ManiTiTz/raunkerfi/rover-build/SWCAD/SWCAD/Import/thingiverse-mount-SharpIR-GP2Y0A21YK0F/images/e8e99f86aa6a258e2d7d2b59b1ce71c8.png

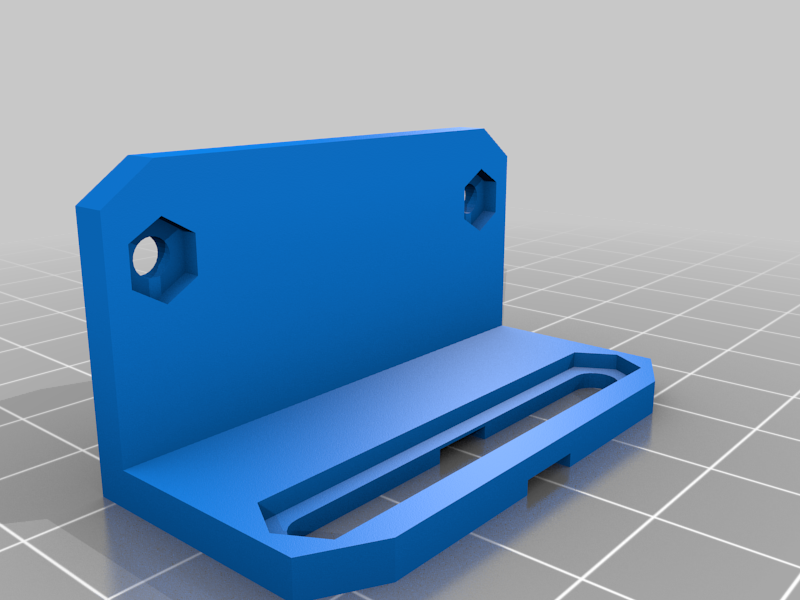
rover-build/SWCAD/SWCAD/Import/thingiverse-mount-SharpIR-GP2Y0A21YK0F/images/e8e99f86aa6a258e2d7d2b59b1ce71c8.png
