ManiTiTz/raunkerfi/rover-build/SWCAD/SWCAD/Import/LM2596 DC-DC convertor HW-411 - 5719964/images/8448f583-9351-4d56-b564-8d736e37746e.png

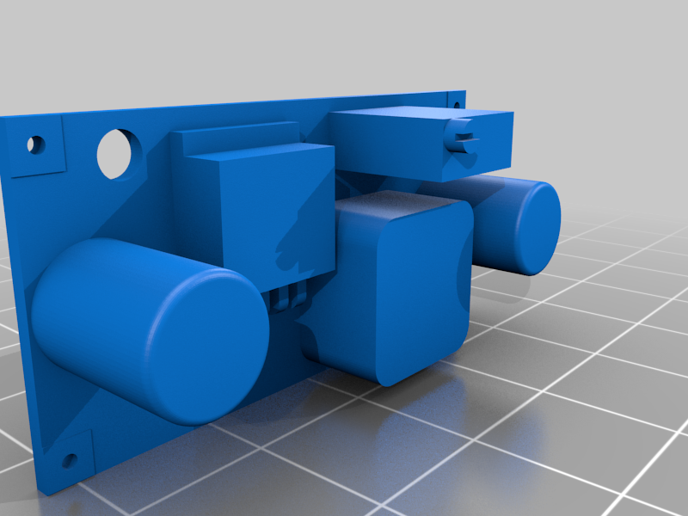
rover-build/SWCAD/SWCAD/Import/LM2596 DC-DC convertor HW-411 - 5719964/images/8448f583-9351-4d56-b564-8d736e37746e.png
