ManiTiTz/raunkerfi/rover-build/SWCAD/SWCAD/README.txt

2025
Caster https://www.dfrobot.com/product-225.html

Powerbank options
https://ikea.is/is/products/heimaskrifstofan/fjoltengi-hledslutaeki-og-rafhlodur/fjoltengi-og-hledslutaeki/varmfront-hledslubanki-art-10555645
https://www.alibaba.com/product-detail/2022-Promotion-Gift-5000Mah-Pocket-Power_1600108552990.html

Protoboards instead of breadboards
https://www.aliexpress.com/item/1005007129593182.html
