ManiTiTz/raunkerfi/rover-build/SWCAD/SWCAD/ASM-robot-chassis-2025.pdf

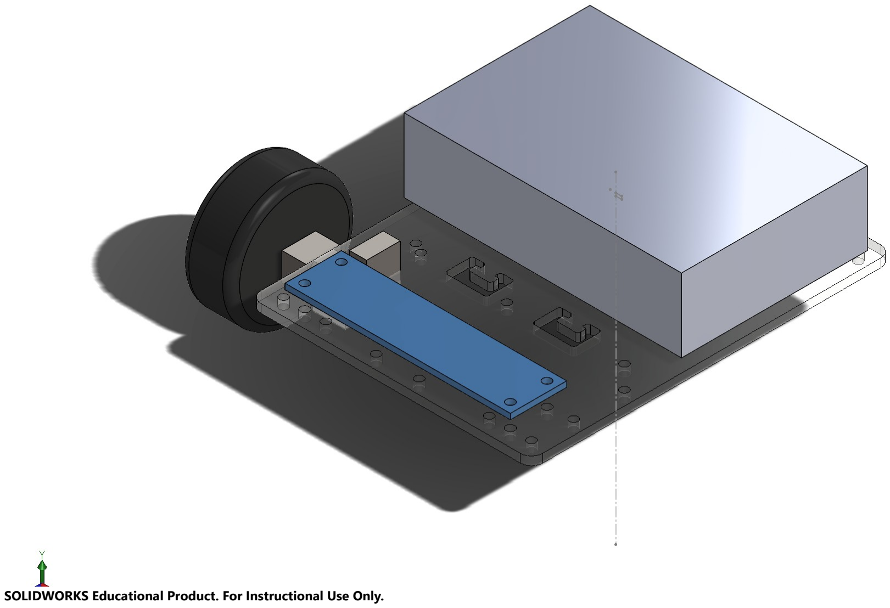
[picture p3: page 1]

SOLIDWORKS Educational Product. For Instructional Use Only.
