ManiTiTz/raunkerfi/rover-build/SWCAD/SWCAD/ASM-robot-chassis-2026-sensorboard.pdf

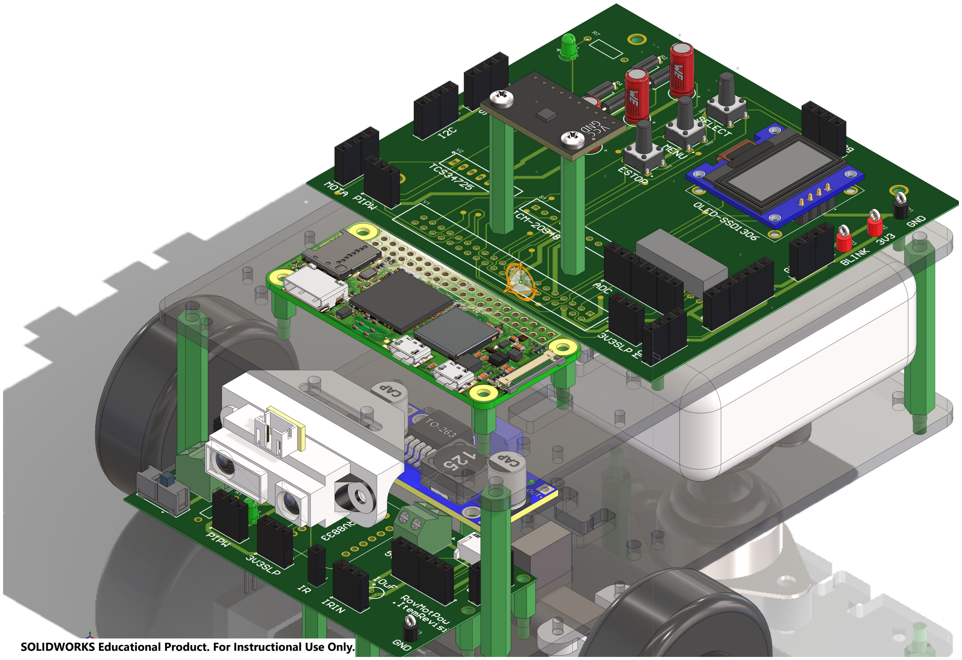
[picture p4: page 1]

SOLIDWORKS Educational Product. For Instructional Use Only.
