ManiTiTz/raunkerfi/rover-build/SWCAD/SWCAD/ASM-robot-chassis-2026.pdf

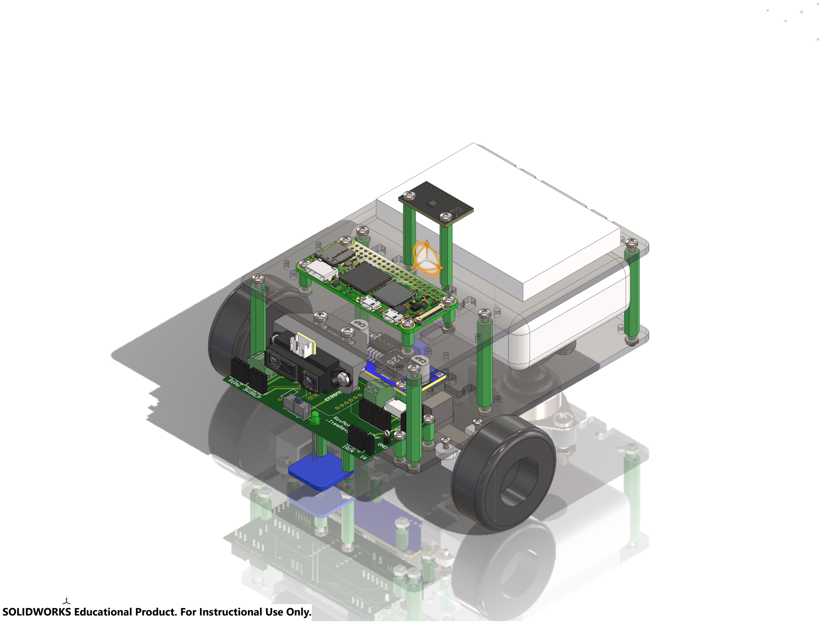
[picture p5: page 1]

SOLIDWORKS Educational Product. For Instructional Use Only.
