ManiTiTz/raunkerfi/books/Book Aug 27, 2026.pdf

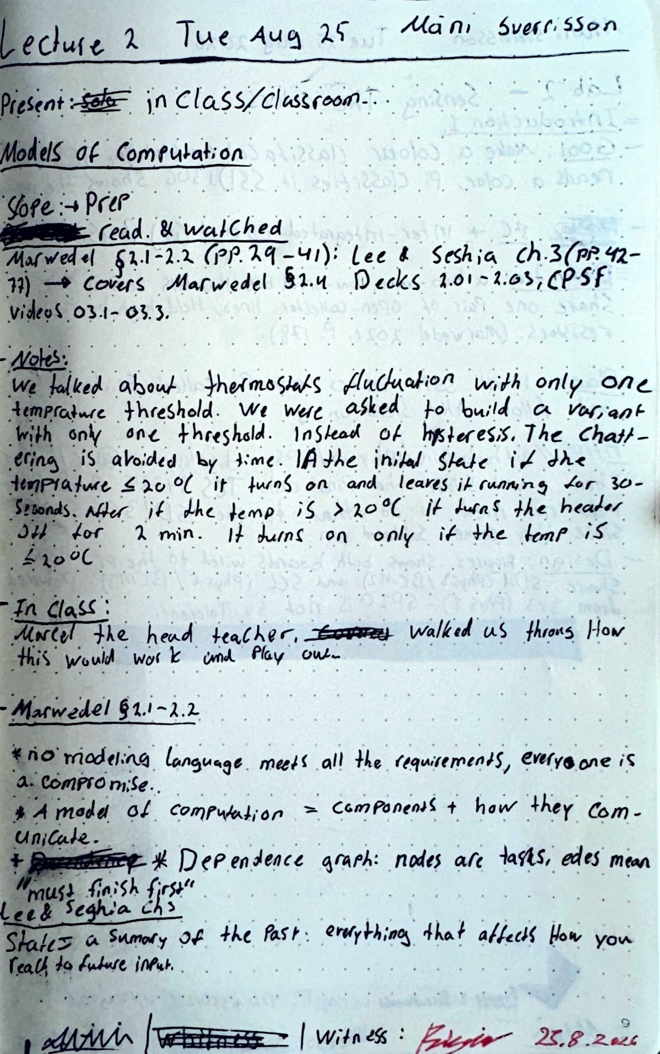
[picture p6: page 1]

### -- ~s~,,~ • . 1:n ~ (a_$S/¢/~~(_t>6~-> -: | • ' • t I I ._•. •

. . . . I
·t1! at· (om,~i~to/\ • • • • . .

~~~~r·....... ·.:: ~ .
. ~f • •• itfA'J..·,;.·we..{Ched •
~~~. ~I . §~.I~ l ._l. (i~f. A 'f. - ~ /) ;· :t ~ l :1. : s:es~; ~ • °c~-3{Pf: tfZ-.1)) ~ ~~U".!. --"'~w~J~l _§;.c.t .0.~,~~- ~-o~ -i:~1>,CP·S:f .
. ~•••,\. O}.f-:- ~~- } | '· · · ".

:~~ktJ :~~o~: }h~~s~s: /J~{kQJ;o~ :w!ih ~n;y : o~e_

.-l•PfQ.JM.le thrtSho/cJ. Wt Wet{. a,$keJ. J-.o b1.tilJ Col Vt;,.,;·.:,nl-
. fi~ ~nv : O~l,-_ f_hrfS~G'~·. JnS~ :01-. ~!e<:t<;if, 7~e.: Cl:z~!- . ,,,~ . is. ~ l,o'.'<At_cl by !:tv1 t ·. I~ ~A~ i_h,'J../. 51-eJe i I J~<

.ffrJ'4fw_t, ~ ).c,_ 0 ( ~t . J~n~ ~I\. e21uA_ l_t"~tS_ ii-_ r~11,_'n~ ~or_ ~-~S .. _ ~ )/._ t~t.. l~IY\.P . ;5 .> ~o 0

( fl- _J..rn~ fit~ J,~aJ,.,,_ . ~-,P.~ • ~or_ . 1_ ~·in. II- Jurn! ~" . o_nly ii- fht!. .km!'. ,'f . ~\o 0 l • • • ••• t • O ♦ t t • 4 • • f •I' .. ••• ♦ • •

~~./J,~'J §1.i-i.i • • • • • • • • |

\~0 ~ ~~t/.·~ta: ~119CA-.~e. ;teJ { '~,; l.~e. (f_'f~t~t,rt~JSI ~r'('lso,,e i~~ «,. Co"1,r c, n,Je.

:- ~ m~J.~ Ot. ~O~f¥fAJ10~ ;_ Cr.~Po/l~nJ~ t: 1-io,V :~~ey' ~ni-
UnJ4«-k | t • ✓• • ~ D eP e11.Je~c t ~~,,~= . n()(/,J ~r, +~~s,. ed,s" mtAA

~fl .f.11.:Sh- f;t1J:1
' | •
1,I >e •~ Cl\)
,~ CA ~~-Y ~I +"-t. f~ri,: qtffytt·,,~· ,lk,,.f ~lh.tJ{ ifo~ yo~
l',-(4 ~ ~t j"'""· | •
- • .. • • • • 11 • • • • • ' • • • '

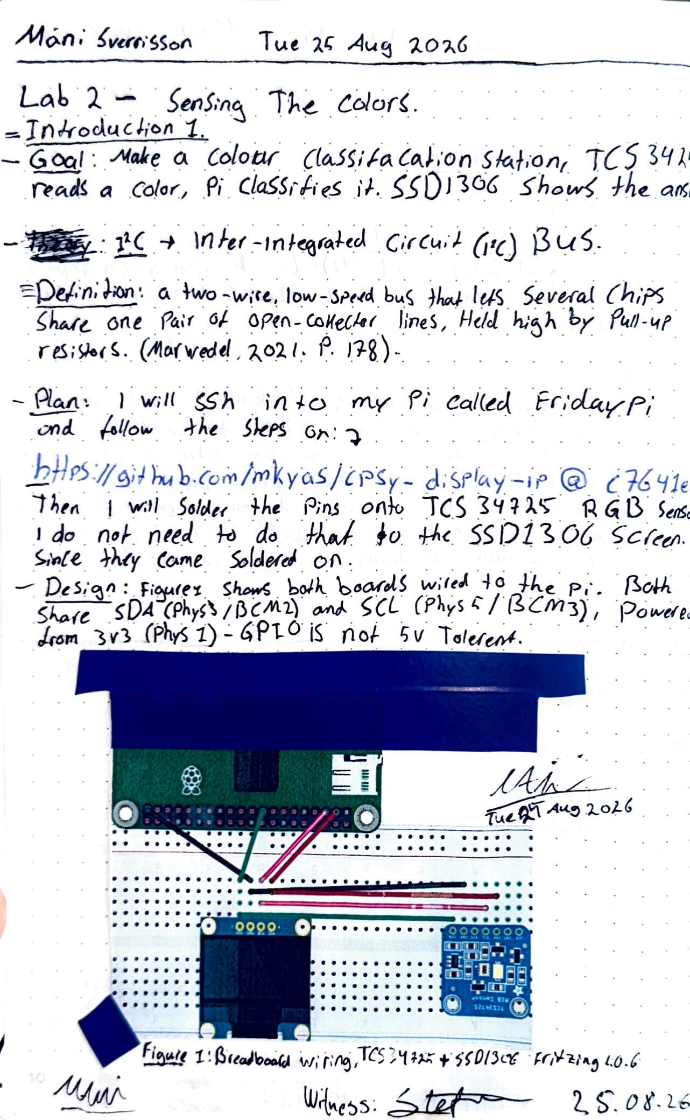
[picture p7: page 2]

### L~b: 1: ~ : $M$tn:~ : i~i : c~~r(. : : .• _' _' .•

~Jnkoclu.cJ,011 1.
- ·Goar: -~at~ ~ .c~1o~: (l~5~il~ (,~.),·o_n ~~f,·o;,f. T.(5 ~4 ~I r,c-ttl~ a .Cc,lor, .Pi. C(a5,St/.i'e~ ,ii .. ~SOJ~~(;. Sho_w{ +h~ a~,

--- ~ J1( ➔: lhfer:-,nf~r~l-t:r.A :c,:rc~.) ()'Cj }3~5: .. ~

=Pl/,:n:J.iOll·. •o.'two~w.:,t; lo,w-·~,,~,(~·b~~ jlu,j. t~s· ~vu-ai {h;fS
~w~ _Otl_t : P~i,: 6~ ~p~"-: eo~ihr: (ine_S ~ :He/cl : ht•~}< by f~tl-~f
re.s;~<_~ .. (~ca(w-~tf,i_o'.)./_. ~- 1_18,)k. . | . ....

### - Pl~·\ • I. ~;1( ~h • in .i.o ·m.v. f/ ea(c~~ :f~,·~v.F/ •

~: ~//~w: :-+~t: ~:k~ :0;:; : : : . . . . .

### _hHP~-t( ~'.J ~ ~-~o~l~~y:u5/ ~1-:)sy:- J;~fl~y-,:f ~: ( t6 '-f Je

1 ~trt I w:H 5olr.Au +he P;,u of\tv i C $ 1 '1 't A~ ~ ~ t1. Sen5<

### - ao: no/-: n1eJ: ~ -d~ }A,) :+o: +./,<=: SSl)t s:o? <;cred'-

>ty,_te_ +hty ~~~e. :5>(olerd. c>" · | • • - D~.s1·~,_, :_f,.~<.t1. s~. b~k.. b.oG\fJ~ ~;,~J. ➔~ -J.~~- p~·- • P.>oJA

S~{~ .~OA. (~hy~\ iBCM1.)_ -~- ~~L. (Ph~S ~ I_B>~~1)_ 1 ·eowelec
J.ro,,. sv1 (PhyS t).:. ~-pio IS ()of r;v Taluel)-I. | • • . | | | . | . | .

r

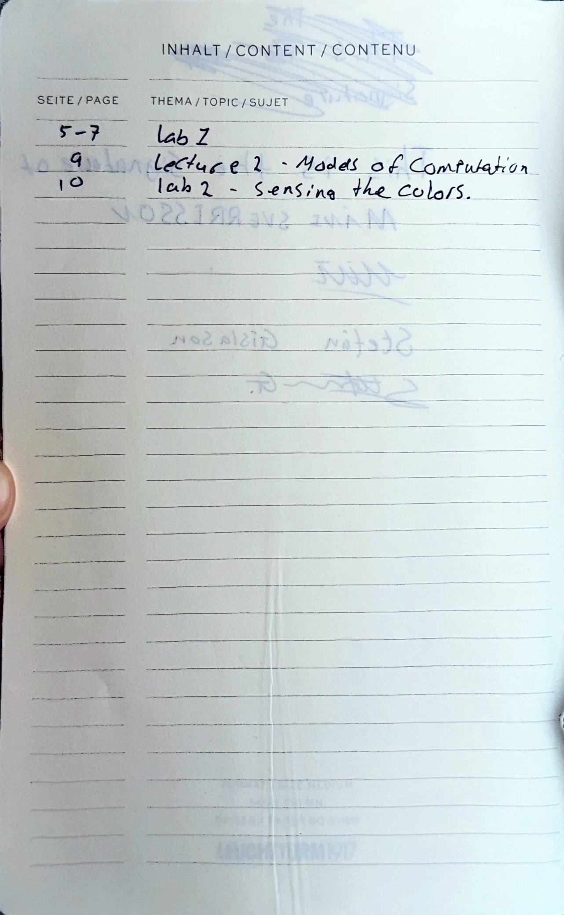
[picture p8: page 3]

SEITE / PAGE
r-1-
q
,o

IN HALT/ CONTENT/ CONTE NU

TH EMA /TOPIC/ SUJET

### iAb Z __

_ le.<_./4c_f_2_ :_ 1/a~~1 o l .LOIY'--fr,JcJr'o11.
I c.tl> l_::_ __ S .e ttS / "-~- Jlue_ Co tcrS.

---·- -----

,
- I
I
