ManiTiTz/raunkerfi/Lab1/0b20301a-474d-4d77-a737-266983e7a903.pdf

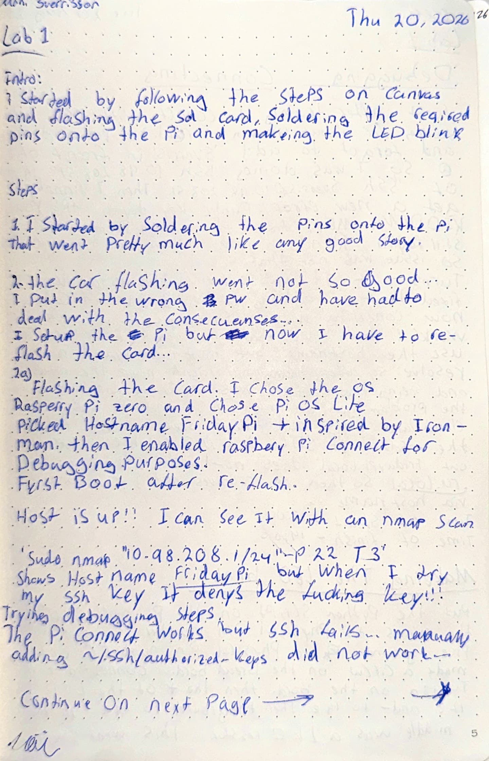
[picture p9: page 1]
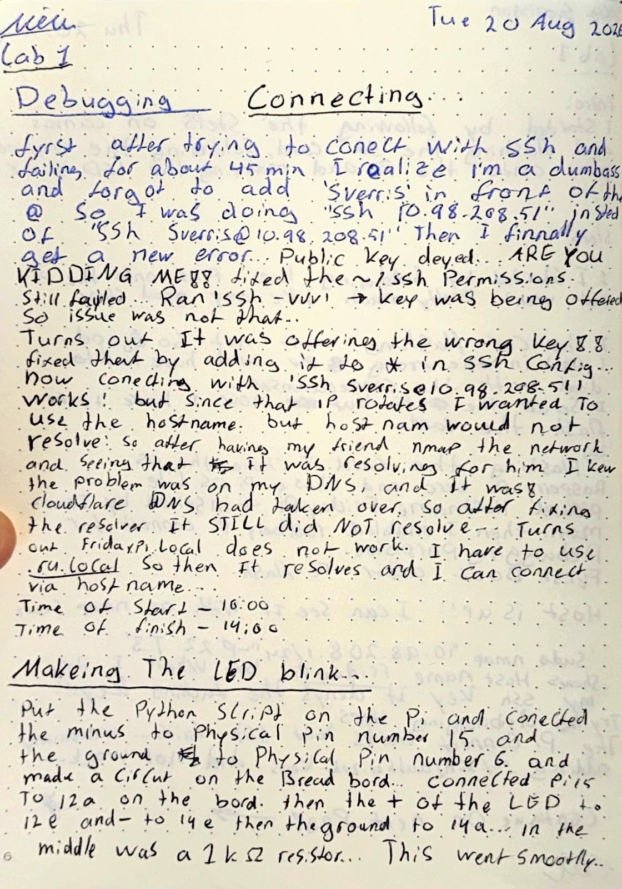
[picture p10: page 2]
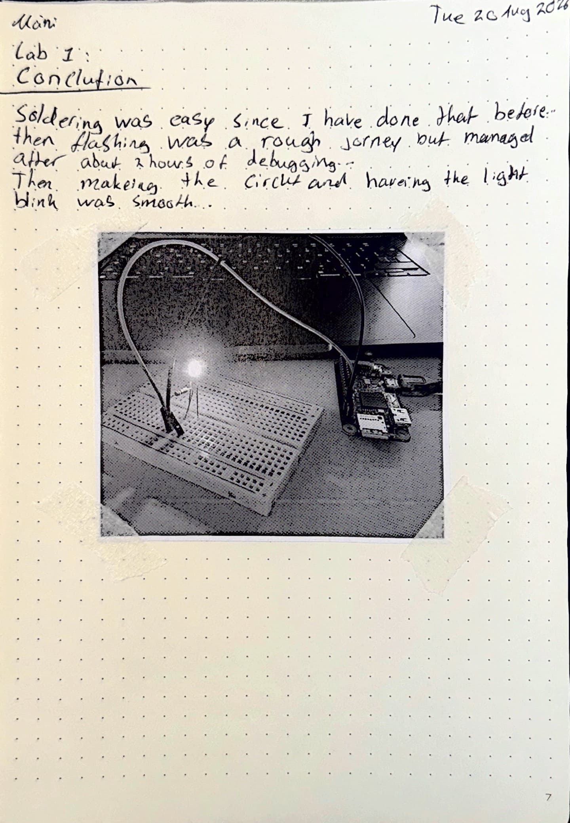
[picture p11: page 3]
