ManiTiTz/raunkerfi/4lab/2026-09-08-07.png

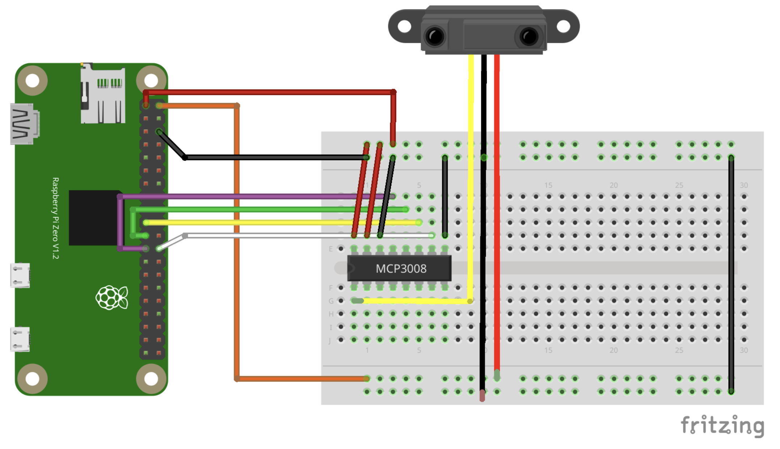
4lab/2026-09-08-07.png
