ManiTiTz/raunkerfi/4lab/2026-09-08_15-07.png

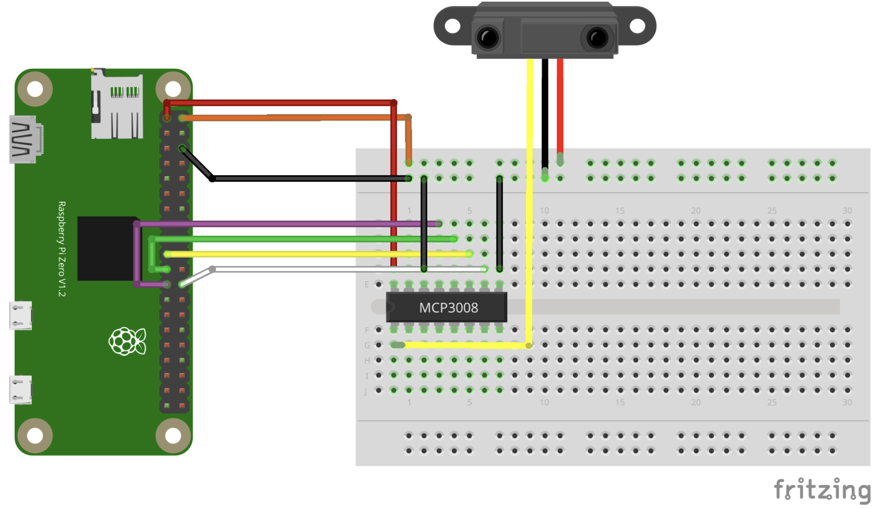
4lab/2026-09-08_15-07.png
