ManiTiTz/raunkerfi/rover-build/SWCAD/SWCAD/ASM-TireHub.SLDASM

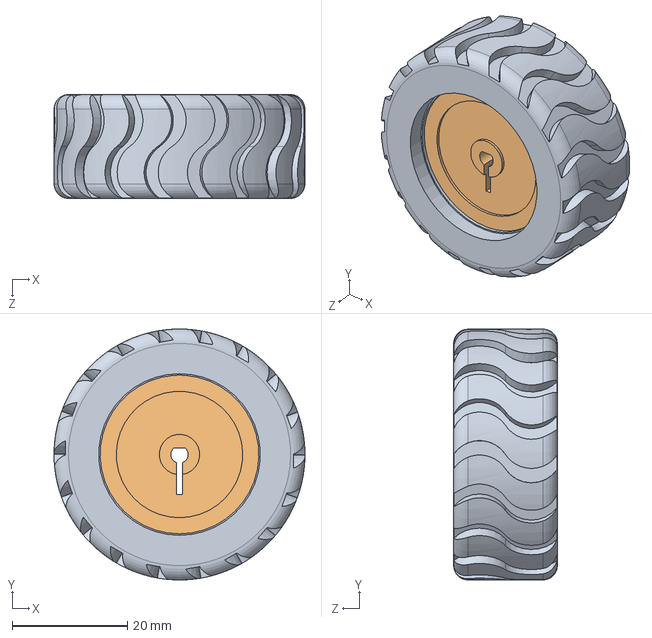
[picture p14: CAD file, 2026-10-19]
rover-build/SWCAD/SWCAD/ASM-TireHub.SLDASM
43.5 x 43.5 x 18.0 mm
hub
tire
