ManiTiTz/raunkerfi/rover-build/SWCAD/SWCAD/ASM-caster.SLDASM

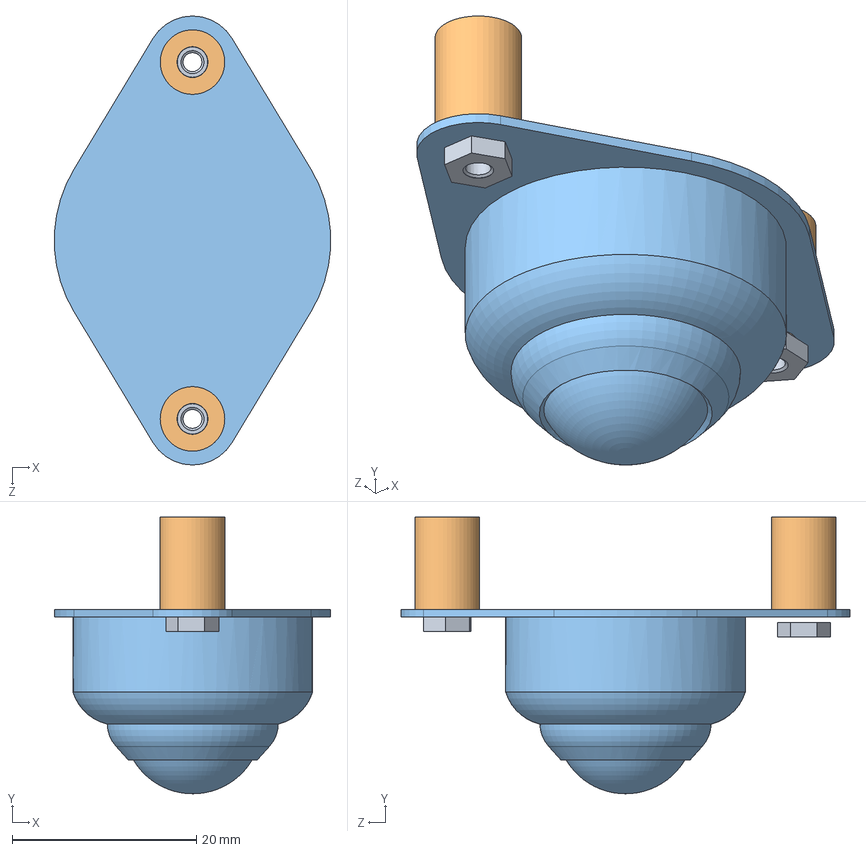
[picture p15: CAD file, 2026-10-19]
rover-build/SWCAD/SWCAD/ASM-caster.SLDASM
29.9 x 30.0 x 48.7 mm
caster-dfrobot225
spacer-caster x 2
nuts-metal x 2
