ManiTiTz/raunkerfi/rover-build/SWCAD/SWCAD/ASM-WheelMotor.SLDASM

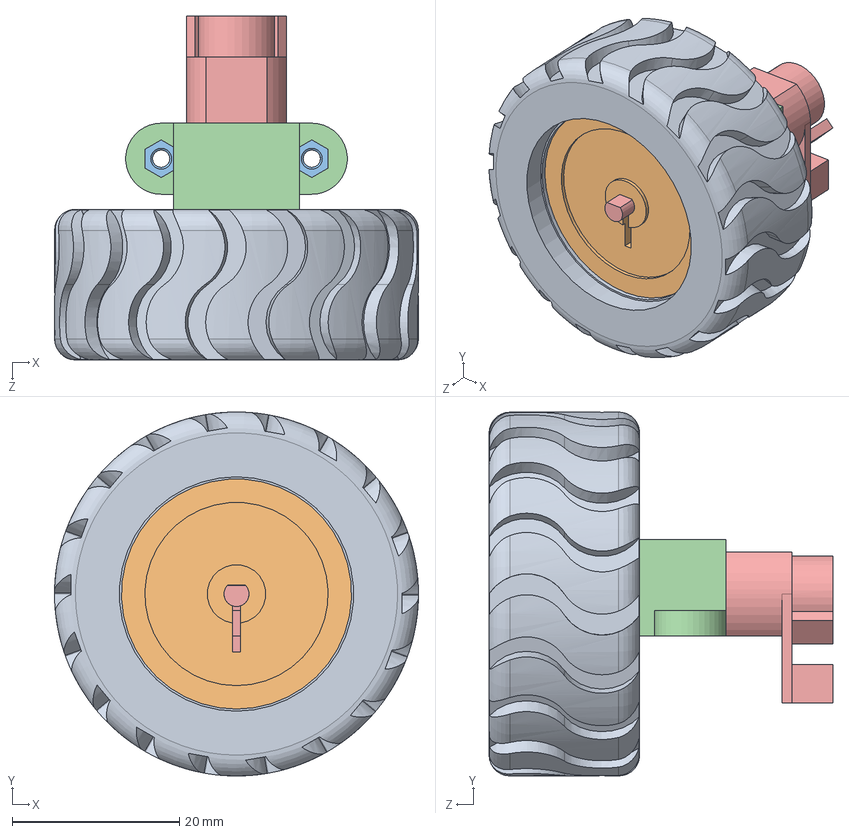
[picture p16: CAD file, 2026-10-19]
rover-build/SWCAD/SWCAD/ASM-WheelMotor.SLDASM
43.5 x 43.5 x 41.1 mm
motor
bracket-motor
nuts-metal x 2
hub
tire
