ManiTiTz/raunkerfi/rover-build/SWCAD/SWCAD/ASM-ColorSensor.SLDASM

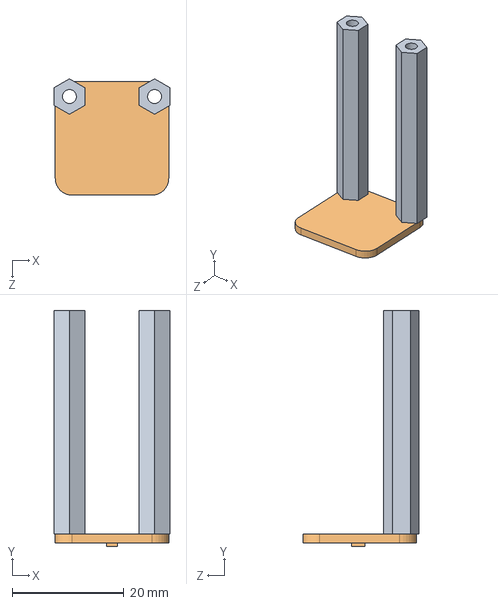
[picture p17: CAD file, 2026-10-19]
rover-build/SWCAD/SWCAD/ASM-ColorSensor.SLDASM
20.7 x 42.2 x 20.8 mm
sensor-color-tcs34725
standoff x 2
