ManiTiTz/raunkerfi/rover-build/SWCAD/SWCAD/ASM-DistanceSensor.SLDASM

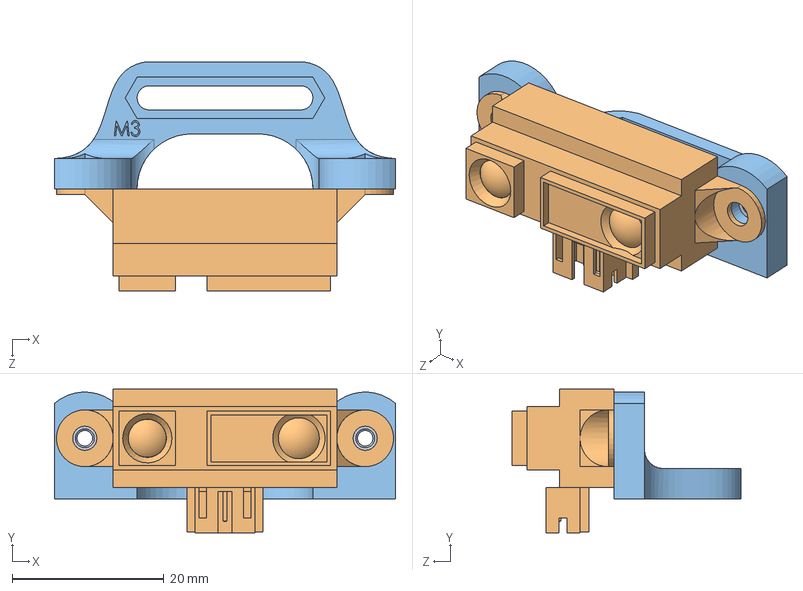
[picture p18: CAD file, 2026-10-19]
rover-build/SWCAD/SWCAD/ASM-DistanceSensor.SLDASM
45.0 x 19.0 x 30.3 mm
bracket-sharp
sensor-Sharp2Y0A21
nuts-metal x 2
