ManiTiTz/raunkerfi/rover-build/SWCAD/SWCAD/AliExpress-ICM20948-IMU-EDM/AliExpress-ICM20948-IMU_BOARD.SLDPRT

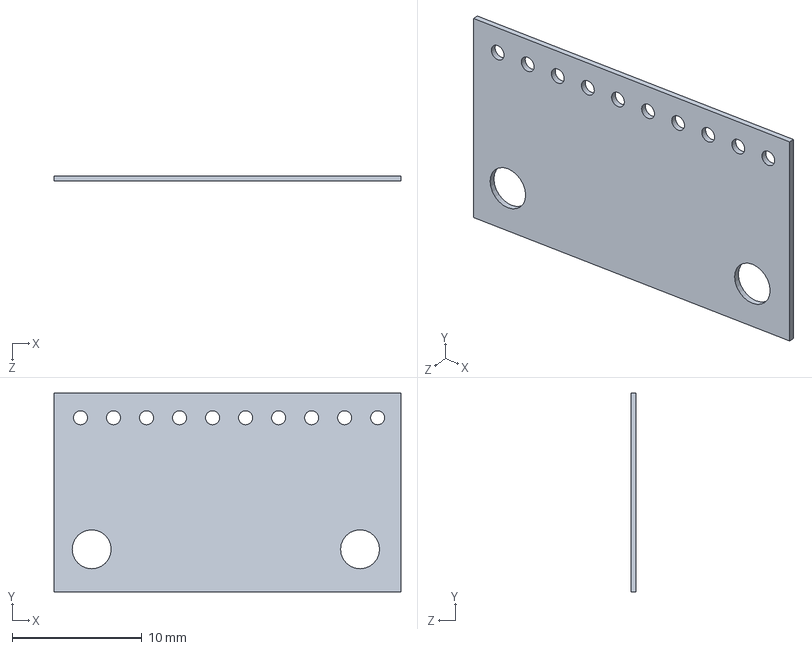
[picture p19: CAD file, 2026-10-19]
rover-build/SWCAD/SWCAD/AliExpress-ICM20948-IMU-EDM/AliExpress-ICM20948-IMU_BOARD.SLDPRT
26.7 x 15.3 x 0.411 mm
