ManiTiTz/raunkerfi/rover-build/SWCAD/SWCAD/Import/LM2596 DC-DC convertor HW-411 - 5719964/files/LM2596_DC-DC_convertor_HW-411.obj

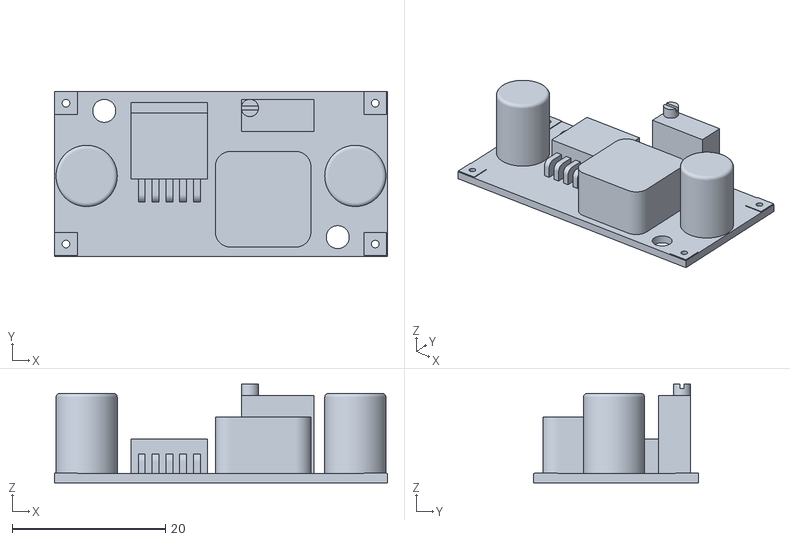
[picture p20: CAD file, 2026-10-19]
rover-build/SWCAD/SWCAD/Import/LM2596 DC-DC convertor HW-411 - 5719964/files/LM2596_DC-DC_convertor_HW-411.obj
43.5 x 21.5 x 12.9
