ManiTiTz/raunkerfi/rover-build/SWCAD/SWCAD/Import/marcel-caster-spacer.stl

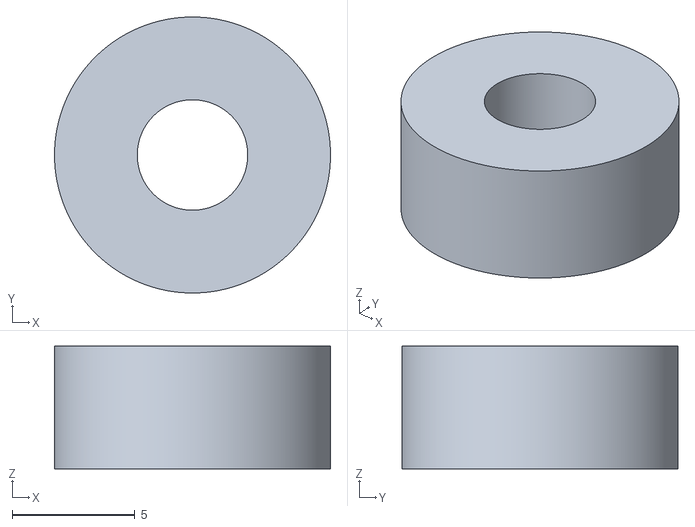
[picture p21: CAD file, 2026-10-19]
rover-build/SWCAD/SWCAD/Import/marcel-caster-spacer.stl
11.2 x 11.2 x 5.00
