ManiTiTz/raunkerfi/rover-build/SWCAD/SWCAD/Import/thingiverse-mount-SharpIR-GP2Y0A21YK0F/files/Support_Capteur_Sharp2.SLDPRT

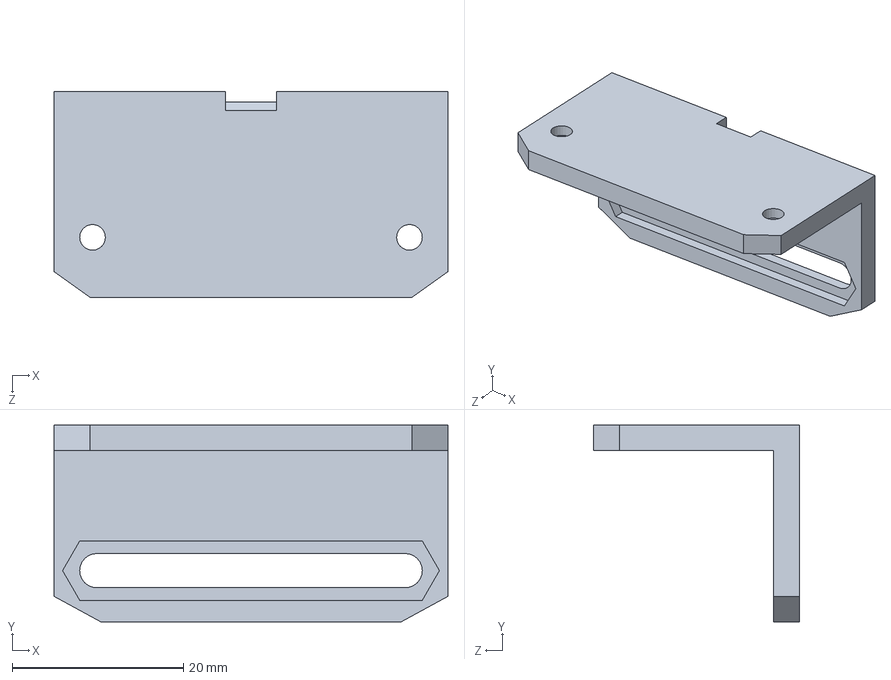
[picture p22: CAD file, 2026-10-19]
rover-build/SWCAD/SWCAD/Import/thingiverse-mount-SharpIR-GP2Y0A21YK0F/files/Support_Capteur_Sharp2.SLDPRT
46.0 x 23.0 x 24.0 mm
