ManiTiTz/raunkerfi/rover-build/SWCAD/SWCAD/RoverMotorPower-EDM/RoverMotorPower_BOARD.SLDPRT

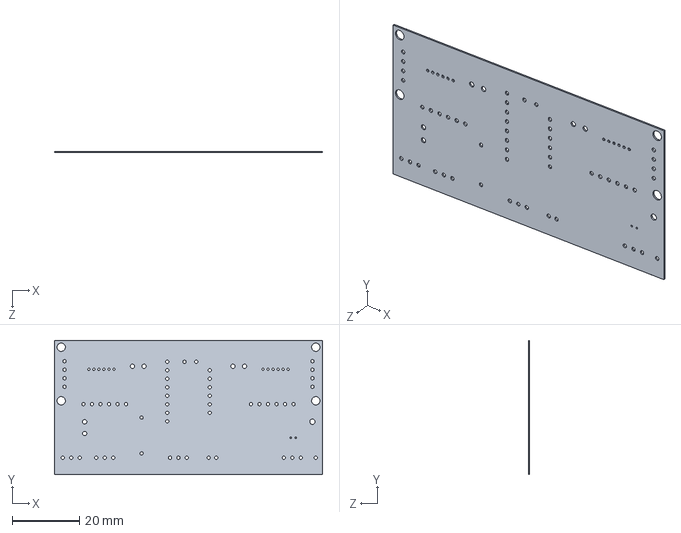
[picture p23: CAD file, 2026-10-19]
rover-build/SWCAD/SWCAD/RoverMotorPower-EDM/RoverMotorPower_BOARD.SLDPRT
80.0 x 40.0 x 0.411 mm
