ManiTiTz/raunkerfi/rover-build/SWCAD/SWCAD/RoverSensor-EDM/Assem2_BOARD.SLDPRT

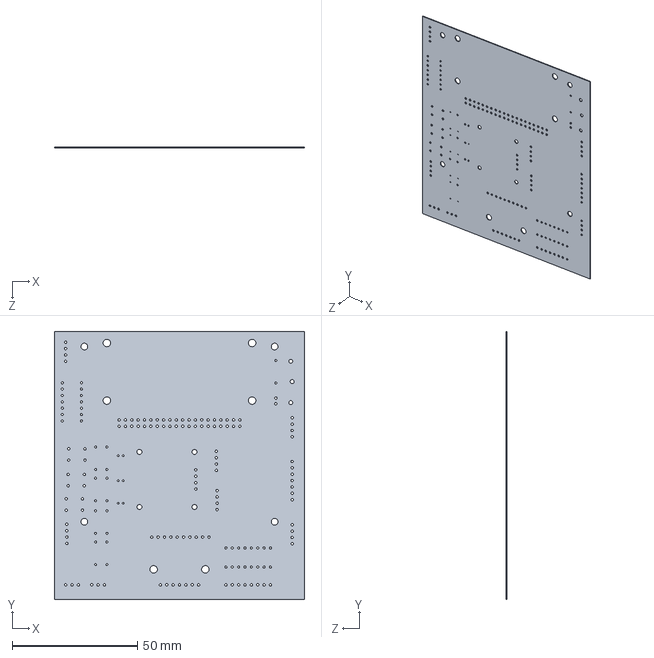
[picture p24: CAD file, 2026-10-19]
rover-build/SWCAD/SWCAD/RoverSensor-EDM/Assem2_BOARD.SLDPRT
100.0 x 107.0 x 0.411 mm
