ManiTiTz/raunkerfi/rover-build/SWCAD/SWCAD/tire.SLDPRT

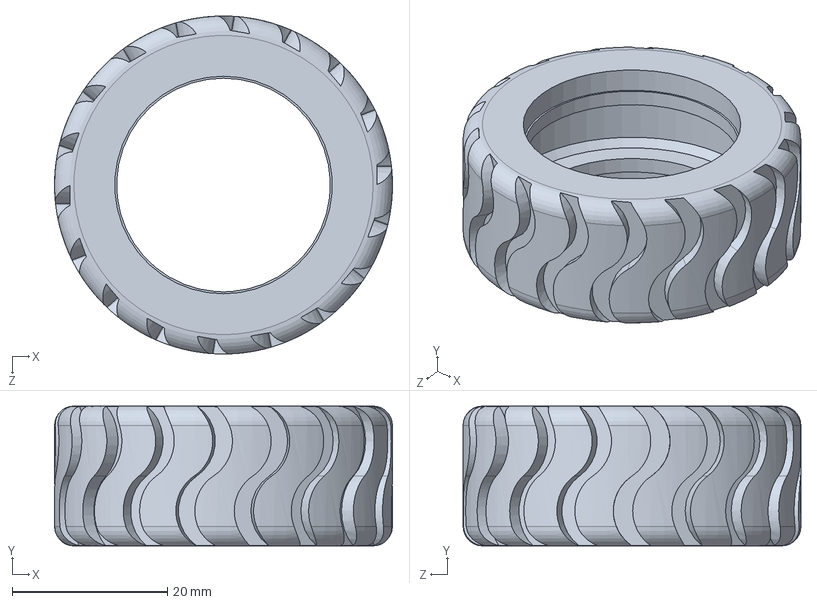
[picture p25: CAD file, 2026-10-19]
rover-build/SWCAD/SWCAD/tire.SLDPRT
43.5 x 18.0 x 43.5 mm
