ManiTiTz/raunkerfi/rover-build/SWCAD/SWCAD/motor.SLDPRT

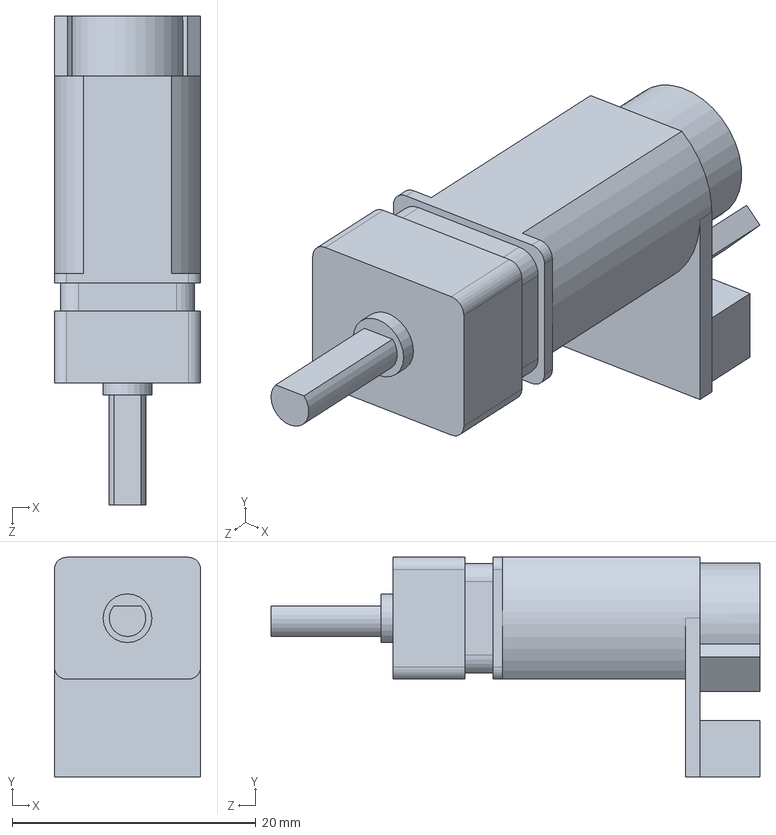
[picture p26: CAD file, 2026-10-19]
rover-build/SWCAD/SWCAD/motor.SLDPRT
12.0 x 18.0 x 40.1 mm
