ManiTiTz/raunkerfi/rover-build/SWCAD/SWCAD/baseplate-1layer.SLDPRT

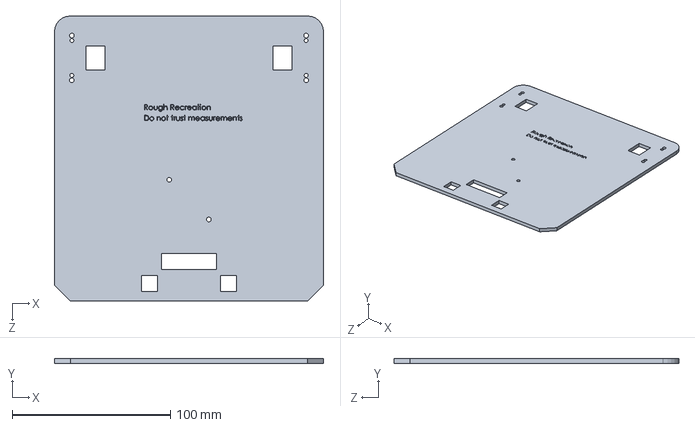
[picture p27: CAD file, 2026-10-19]
rover-build/SWCAD/SWCAD/baseplate-1layer.SLDPRT
170.0 x 3.00 x 180.0 mm
