ManiTiTz/raunkerfi/rover-build/SWCAD/SWCAD/bracket-sharp.SLDPRT

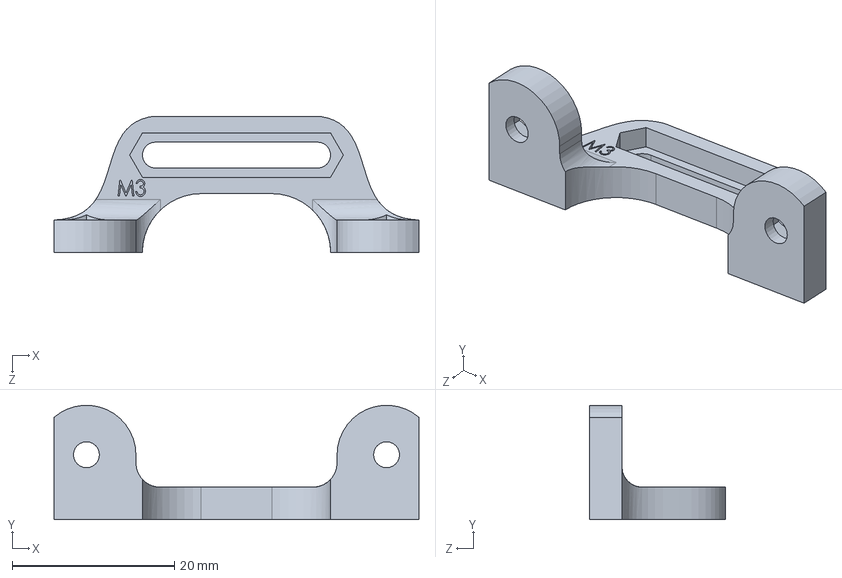
[picture p28: CAD file, 2026-10-19]
rover-build/SWCAD/SWCAD/bracket-sharp.SLDPRT
45.0 x 14.1 x 16.8 mm
