ManiTiTz/raunkerfi/rover-build/SWCAD/SWCAD/spacer-oldstandoff.SLDPRT

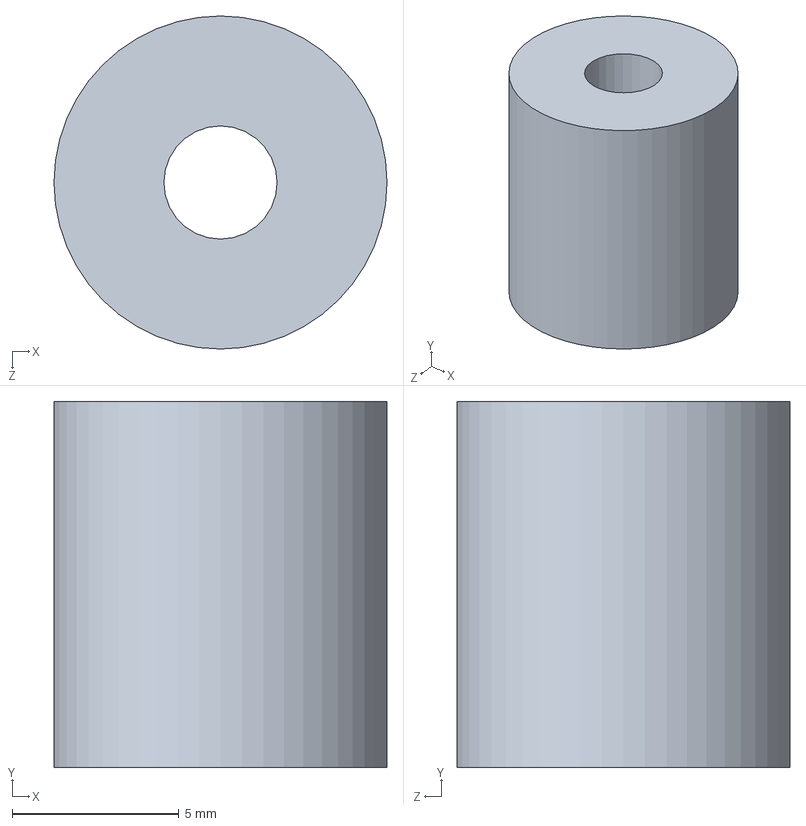
[picture p29: CAD file, 2026-10-19]
rover-build/SWCAD/SWCAD/spacer-oldstandoff.SLDPRT
10.0 x 11.0 x 10.0 mm
