ManiTiTz/raunkerfi/rover-build/SWCAD/SWCAD/spacer-caster.SLDPRT

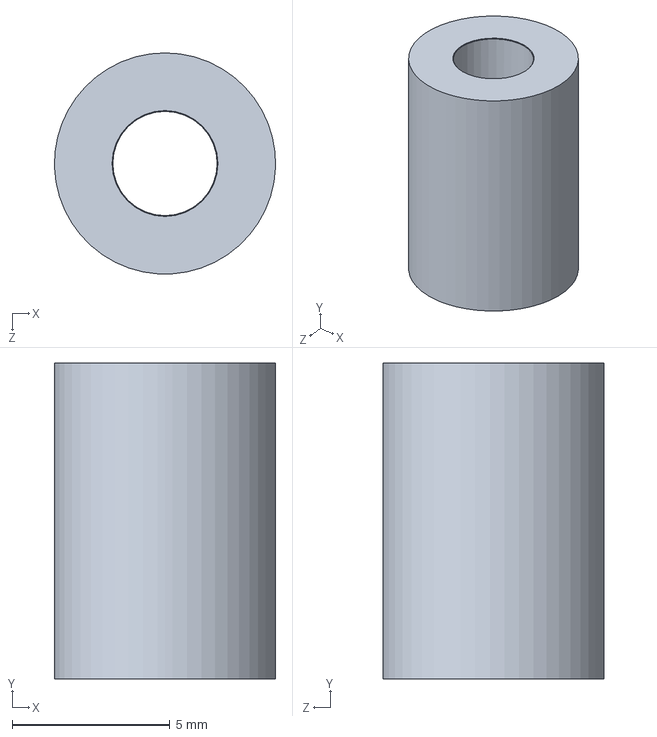
[picture p30: CAD file, 2026-10-19]
rover-build/SWCAD/SWCAD/spacer-caster.SLDPRT
7.00 x 10.0 x 7.00 mm
