ManiTiTz/raunkerfi/rover-build/SWCAD/SWCAD/nuts-plastic.SLDPRT

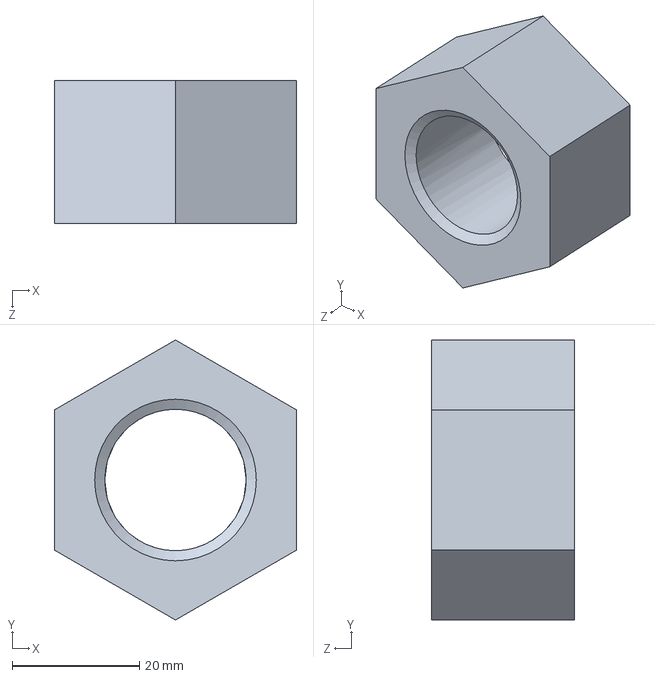
[picture p31: CAD file, 2026-10-19]
rover-build/SWCAD/SWCAD/nuts-plastic.SLDPRT
38.1 x 44.0 x 22.5 mm
