ManiTiTz/raunkerfi/rover-build/SWCAD/SWCAD/bracket-lift.SLDPRT

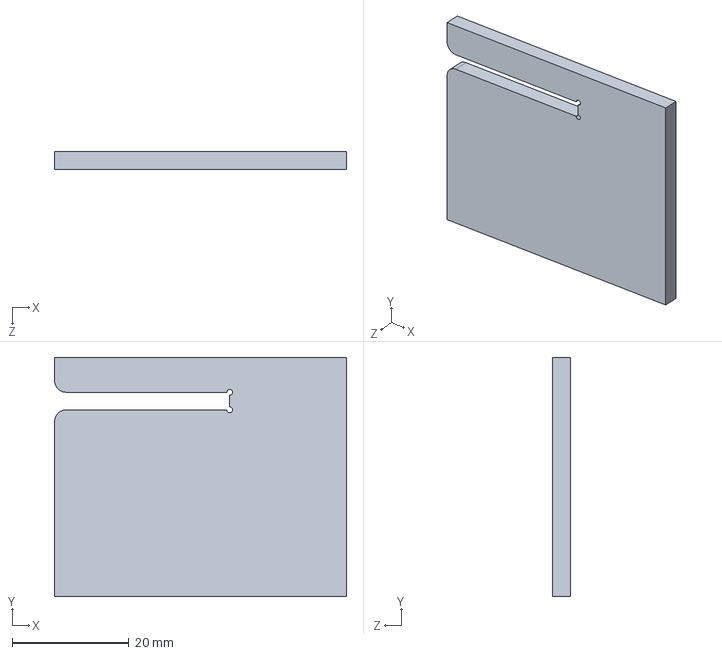
[picture p32: CAD file, 2026-10-19]
rover-build/SWCAD/SWCAD/bracket-lift.SLDPRT
50.0 x 41.0 x 3.00 mm
