ManiTiTz/raunkerfi/rover-build/SWCAD/SWCAD/sensor-Sharp2Y0A21.SLDPRT

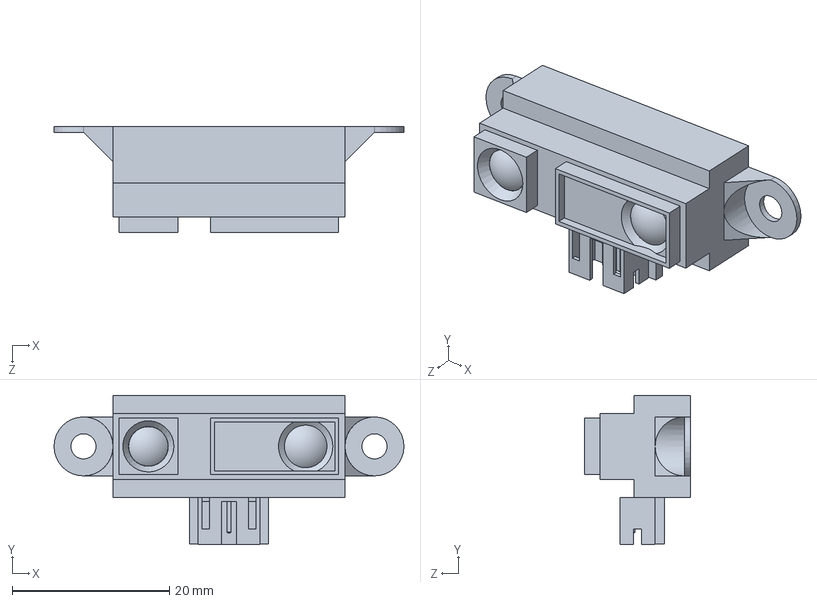
[picture p33: CAD file, 2026-10-19]
rover-build/SWCAD/SWCAD/sensor-Sharp2Y0A21.SLDPRT
44.5 x 19.0 x 13.5 mm
