ManiTiTz/raunkerfi/rover-build/SWCAD/SWCAD/C1020-DC-powerbank.SLDPRT

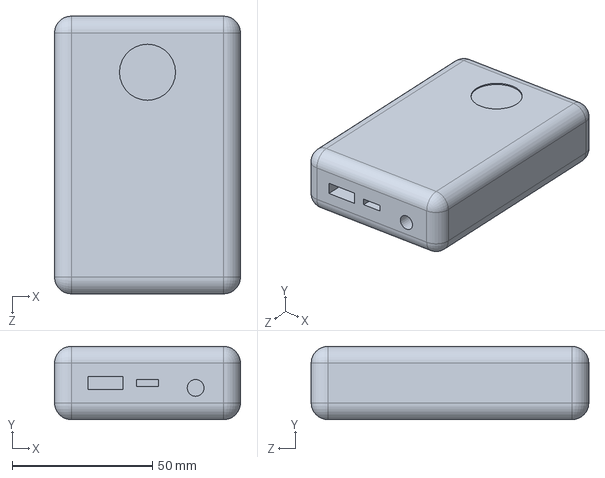
[picture p34: CAD file, 2026-10-19]
rover-build/SWCAD/SWCAD/C1020-DC-powerbank.SLDPRT
66.3 x 26.1 x 99.0 mm
