ManiTiTz/raunkerfi/rover-build/SWCAD/SWCAD/nuts-metal.SLDPRT

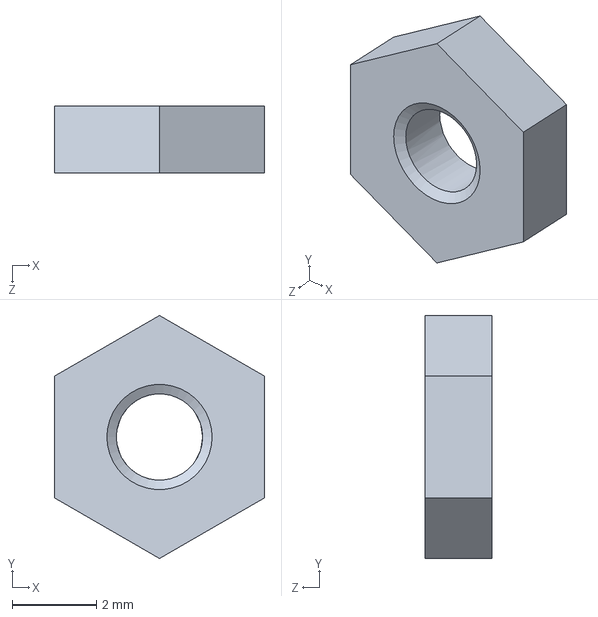
[picture p35: CAD file, 2026-10-19]
rover-build/SWCAD/SWCAD/nuts-metal.SLDPRT
5.00 x 5.77 x 1.60 mm
