ManiTiTz/raunkerfi/rover-build/SWCAD/SWCAD/wheel-simple.SLDPRT

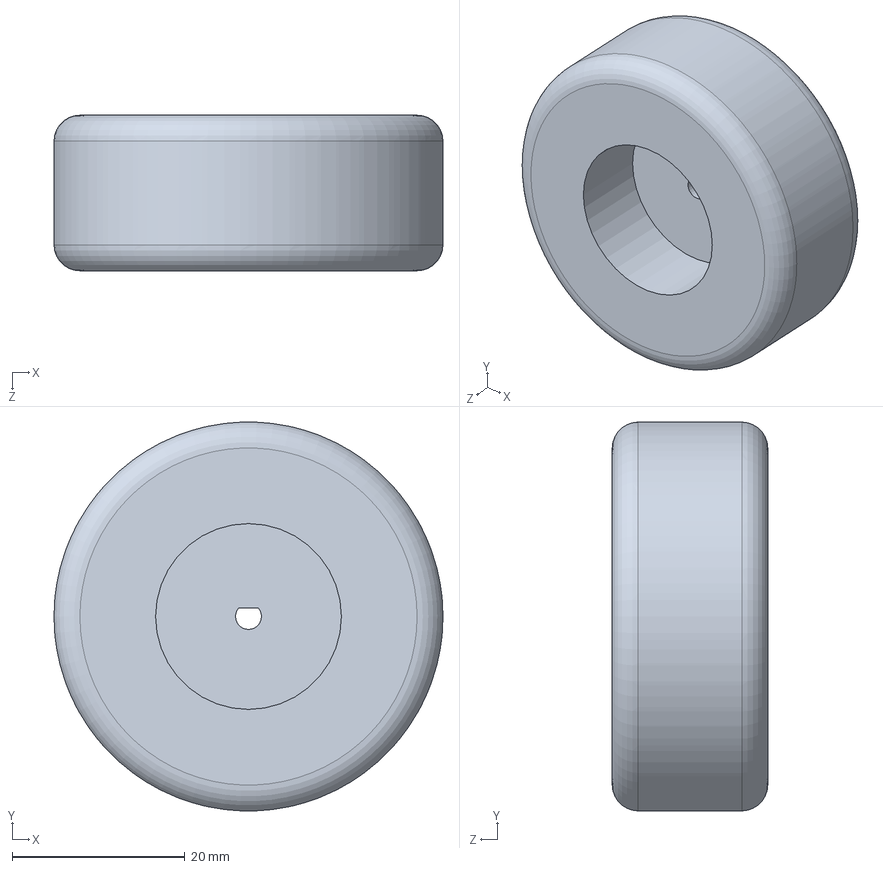
[picture p36: CAD file, 2026-10-19]
rover-build/SWCAD/SWCAD/wheel-simple.SLDPRT
45.0 x 45.0 x 18.0 mm
