ManiTiTz/raunkerfi/rover-build/SWCAD/SWCAD/breadboard-halfsize.SLDPRT

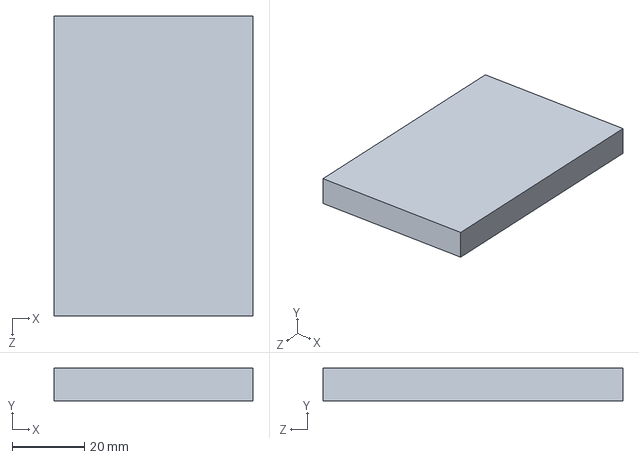
[picture p37: CAD file, 2026-10-19]
rover-build/SWCAD/SWCAD/breadboard-halfsize.SLDPRT
55.0 x 9.00 x 83.0 mm
