ManiTiTz/raunkerfi/rover-build/SWCAD/SWCAD/hub.SLDPRT

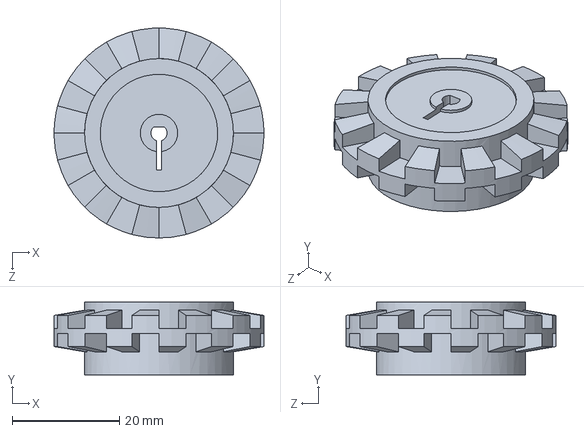
[picture p38: CAD file, 2026-10-19]
rover-build/SWCAD/SWCAD/hub.SLDPRT
39.2 x 13.6 x 39.2 mm
