ManiTiTz/raunkerfi/rover-build/SWCAD/SWCAD/caster-dfrobot225.SLDPRT

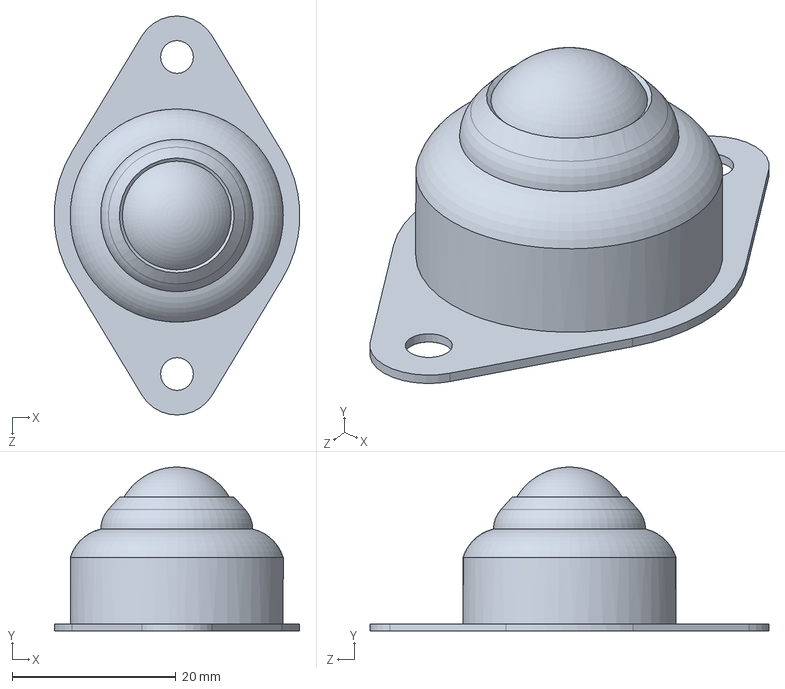
[picture p39: CAD file, 2026-10-19]
rover-build/SWCAD/SWCAD/caster-dfrobot225.SLDPRT
29.9 x 20.0 x 48.7 mm
