ManiTiTz/raunkerfi/rover-build/SWCAD/SWCAD/mount-adhesive-3mm.SLDPRT

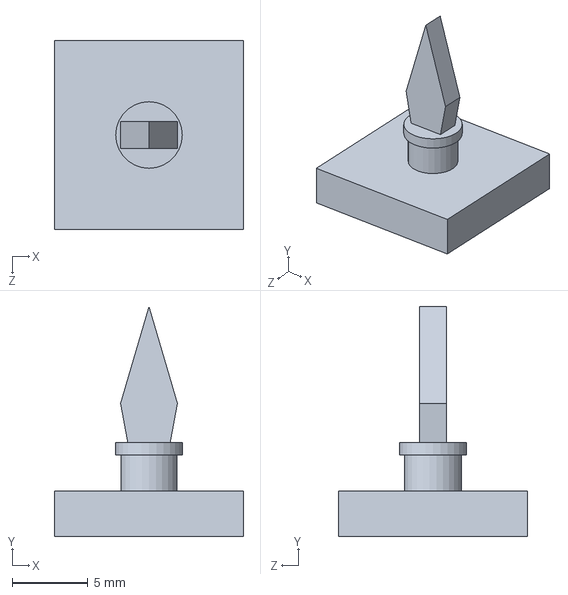
[picture p40: CAD file, 2026-10-19]
rover-build/SWCAD/SWCAD/mount-adhesive-3mm.SLDPRT
12.5 x 15.2 x 12.5 mm
