ManiTiTz/raunkerfi/rover-build/SWCAD/SWCAD/baseplate-marcel.SLDPRT

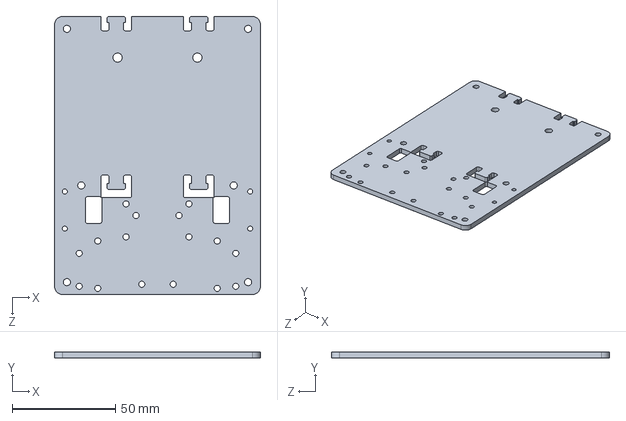
[picture p41: CAD file, 2026-10-19]
rover-build/SWCAD/SWCAD/baseplate-marcel.SLDPRT
100.0 x 3.00 x 135.0 mm
