ManiTiTz/raunkerfi/rover-build/SWCAD/SWCAD/bracket-motor.SLDPRT

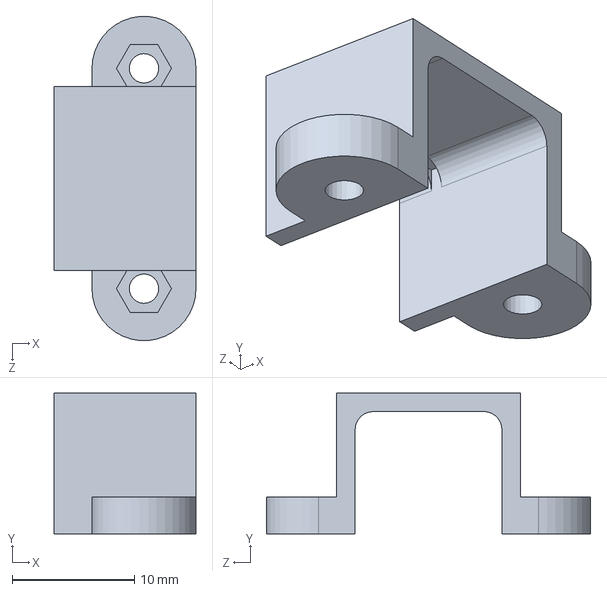
[picture p42: CAD file, 2026-10-19]
rover-build/SWCAD/SWCAD/bracket-motor.SLDPRT
11.6 x 11.5 x 26.5 mm
