ManiTiTz/raunkerfi/rover-build/SWCAD/SWCAD/sensor-color-tcs34725.SLDPRT

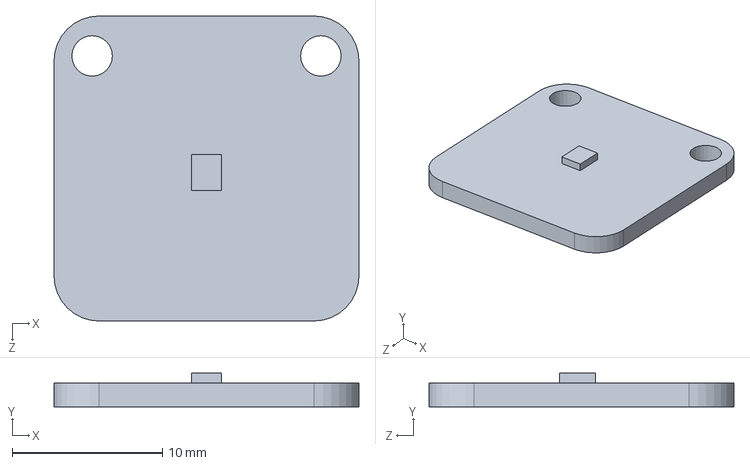
[picture p43: CAD file, 2026-10-19]
rover-build/SWCAD/SWCAD/sensor-color-tcs34725.SLDPRT
20.3 x 2.25 x 20.3 mm
