ManiTiTz/raunkerfi/rover-build/SWCAD/SWCAD/standoff.SLDPRT

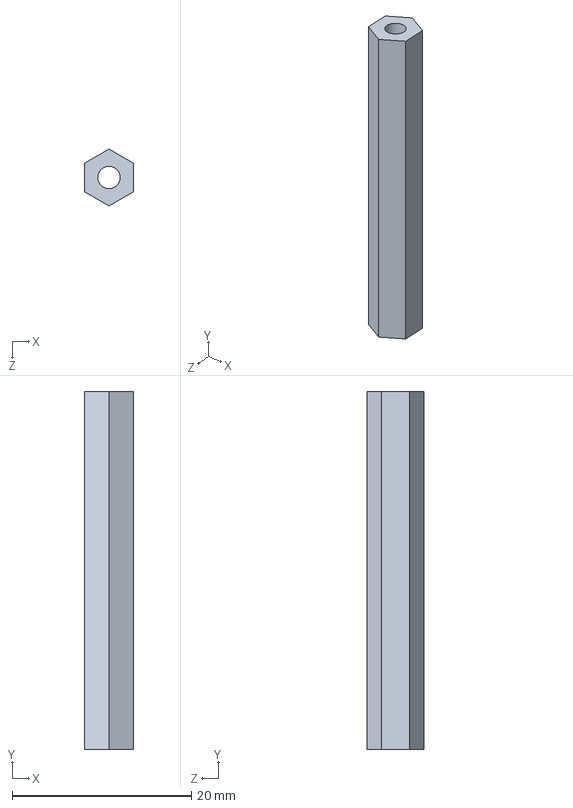
[picture p44: CAD file, 2026-10-19]
rover-build/SWCAD/SWCAD/standoff.SLDPRT
5.50 x 40.0 x 6.35 mm
