ManiTiTz/raunkerfi/rover-build/SWCAD/SWCAD/ASM-Rover-Layer2.SLDASM

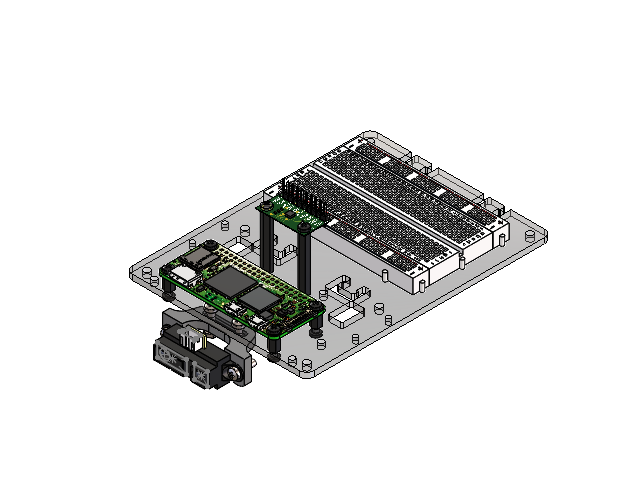
[picture p45: CAD file, 2026-10-19]
rover-build/SWCAD/SWCAD/ASM-Rover-Layer2.SLDASM
baseplate-marcel
AliExpress-ICM20948-IMU_BOARD
RESC0402(1005)_L_CMP-009-00066-2
RESC0402(1005)_L_CMP-009-00071-2
QFN40P300X300X105-25N_CMP-010-00031-4
SMTC-PHT-110-01-X-S_CMP-002-00252-2
CAPC1005X56X25LL10T15_CMP-001-00001-6 x 3
standoff x 6
screws-plastic x 12
PCB, Raspberry Pi Zero 2 W
RP3A0-AU 2105 201221C, Raspberry Pi Zero 2 W
MicroUSB Port, Raspberry Pi Zero 2 W x 2
SD Card Slot, Raspberry Pi Zero 2 W
Wireless Module Cover, Raspberry Pi Zero 2 W
Crystal Resonator, Raspberry Pi Zero 2 W
LED, Raspberry Pi Zero 2 W
Diode, Schottky, Raspberry Pi Zero 2 W
54548-2271, 22 Pin FPC Connector, Raspberry Pi Zero 2 W
Mini HDMI Receptacle Port, Raspberry Pi Zero 2 W
PAM2306AYPKE, Switching Voltage Regulators Dual PWM Step-Down 40uA 1A 1.5MHz, Raspberry Pi Zero 2 W
RT9081A-1BGQZA, Fixed LDO Voltage Regulator, 0.8V-5.5Vin, 140mV drop, 1.25Vout, 0.5Aout, Raspberry Pi Zero 2 W
RT8088AWSC, IC Reg Buck Prog 3A Sync 15WLCSP, Raspberry Pi Zero 2 W
SMD Inductor, Configurable, Raspberry Pi Zero 2 W x 2
SMD Capacitor, Configurable, Raspberry Pi Zero 2 W x 56
SMD Resistor, Configurable, Raspberry Pi Zero 2 W x 21
bracket-sharp
sensor-Sharp2Y0A21
nuts-metal x 4
screws-metal x 4
Main Half-Size Board
Half-Size Side Rail x 2
