ManiTiTz/raunkerfi/rover-build/SWCAD/SWCAD/ASM-SensorBoard.SLDASM

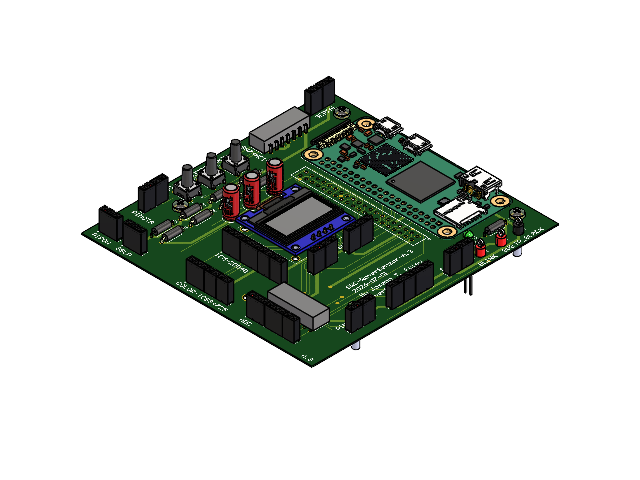
[picture p47: CAD file, 2026-10-19]
rover-build/SWCAD/SWCAD/ASM-SensorBoard.SLDASM
Assem2_BOARD
PDIP300-P16_CMP-020-00025-1
TP_RED_CMP-011-000003-2 x 2
TP_BLACK_CMP-011-000001-2
FP-B3F-1070-MFG_CMP-011-00002-3 x 3
RESA60-630X240_CMP-009-00046-4 x 3
RESA60-630X240_CMP-009-00047-4 x 4
LED-2P-2.28-3MM_CMP-007-00006-3
HDR_F_1X4_CMP-002-00296-2 x 6
HDR_F_1X7_CMP-002-00300-2
HDR_F_1X3_CMP-002-00285-1 x 2
Adafruit-938-FootprintMount-1_CMP-007-00036-6
WCAP-ATG8_D5H11_CMP-001-00095-2 x 3
HDR_F_1X8_CMP-002-00301-2
N0014A_CMP-015-00010-1
RESA60-630X240_CMP-009-00203-3
HDR_F_1X7_CMP-010-00027-9
MODULE_RASPBERRY_PI_ZERO_2_W_AND_CABLE_CMP-074-000000-9
HDR_F_1X10_CMP-00030-00015-5
RESA60-630X240_CMP-009-00204-1
standoff x 4
screws-plastic x 4
