ManiTiTz/raunkerfi/rover-build/SWCAD/SWCAD/ASM-MCU.SLDASM

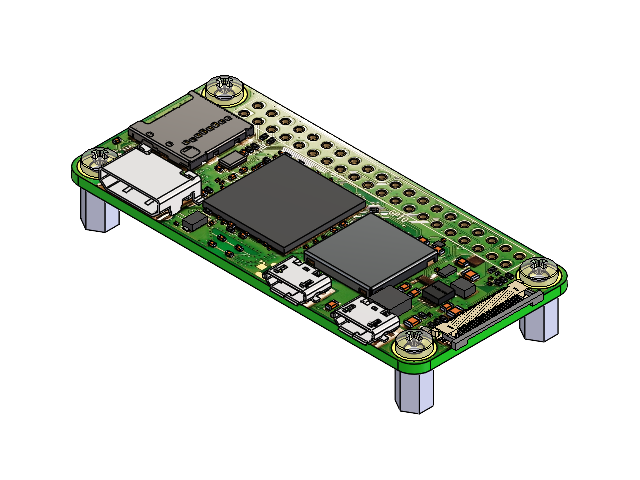
[picture p48: CAD file, 2026-10-19]
rover-build/SWCAD/SWCAD/ASM-MCU.SLDASM
PCB, Raspberry Pi Zero 2 W
RP3A0-AU 2105 201221C, Raspberry Pi Zero 2 W
MicroUSB Port, Raspberry Pi Zero 2 W x 2
SD Card Slot, Raspberry Pi Zero 2 W
Wireless Module Cover, Raspberry Pi Zero 2 W
Crystal Resonator, Raspberry Pi Zero 2 W
LED, Raspberry Pi Zero 2 W
Diode, Schottky, Raspberry Pi Zero 2 W
54548-2271, 22 Pin FPC Connector, Raspberry Pi Zero 2 W
Mini HDMI Receptacle Port, Raspberry Pi Zero 2 W
PAM2306AYPKE, Switching Voltage Regulators Dual PWM Step-Down 40uA 1A 1.5MHz, Raspberry Pi Zero 2 W
RT9081A-1BGQZA, Fixed LDO Voltage Regulator, 0.8V-5.5Vin, 140mV drop, 1.25Vout, 0.5Aout, Raspberry Pi Zero 2 W
RT8088AWSC, IC Reg Buck Prog 3A Sync 15WLCSP, Raspberry Pi Zero 2 W
SMD Inductor, Configurable, Raspberry Pi Zero 2 W x 2
SMD Capacitor, Configurable, Raspberry Pi Zero 2 W x 56
SMD Resistor, Configurable, Raspberry Pi Zero 2 W x 21
standoff x 4
screws-plastic x 4
