ManiTiTz/raunkerfi/rover-build/SWCAD/SWCAD/AliExpress-ICM20948-IMU.SLDASM

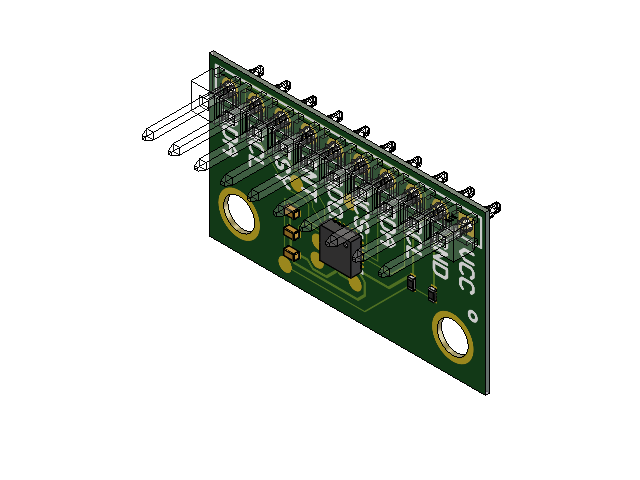
[picture p51: CAD file, 2026-10-19]
rover-build/SWCAD/SWCAD/AliExpress-ICM20948-IMU.SLDASM
AliExpress-ICM20948-IMU_BOARD
RESC0402(1005)_L_CMP-009-00066-2
RESC0402(1005)_L_CMP-009-00071-2
QFN40P300X300X105-25N_CMP-010-00031-4
SMTC-PHT-110-01-X-S_CMP-002-00252-2
CAPC1005X56X25LL10T15_CMP-001-00001-6 x 3
