ManiTiTz/raunkerfi/rover-build/SWCAD/SWCAD/ASM-DCDC.SLDASM

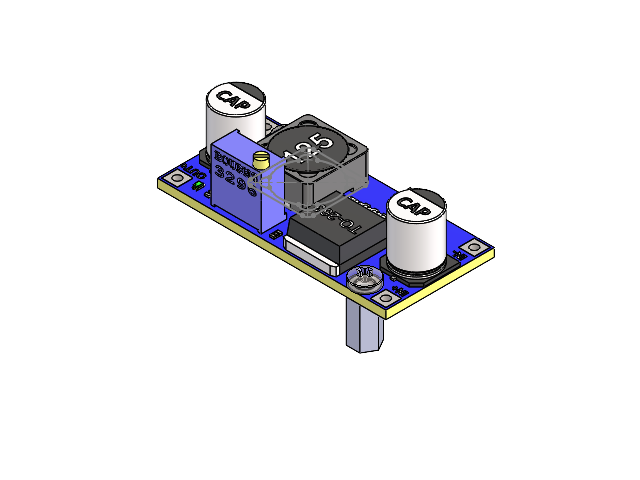
[picture p52: CAD file, 2026-10-19]
rover-build/SWCAD/SWCAD/ASM-DCDC.SLDASM
Board^ADIY-LM2596
RES_3296W^ADIY-LM2596
TO-263-5^ADIY-LM2596
CAP_SMD_AL_08.0x10.0^ADIY-LM2596 x 2
RES_SMD_0603^ADIY-LM2596 x 2
CAP_SMD_0603_H0.50^ADIY-LM2596 x 2
001^CDRH125_ADIY-LM2596
002^CDRH125_ADIY-LM2596
005^CDRH125_ADIY-LM2596 x 2
003^CDRH125_ADIY-LM2596
Diode_DO214AC(SMA)^ADIY-LM2596
LED_0603_Green^ADIY-LM2596
standoff x 2
screws-plastic x 2
