ManiTiTz/raunkerfi/rover-build/SWCAD/SWCAD/ASM-MotorPower.SLDASM

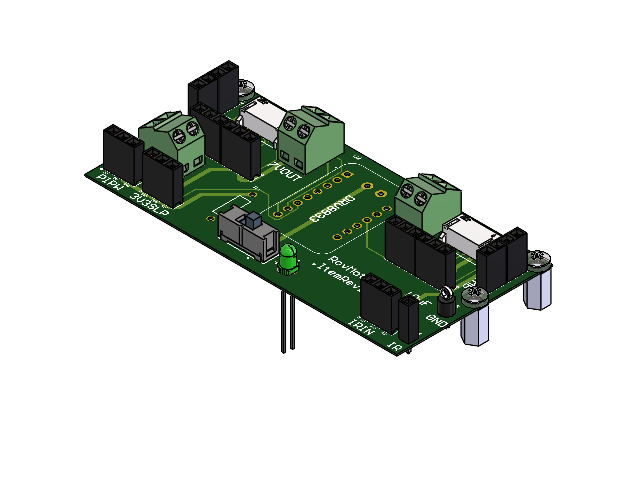
[picture p53: CAD file, 2026-10-19]
rover-build/SWCAD/SWCAD/ASM-MotorPower.SLDASM
RoverMotorPower_BOARD
TP_BLACK_CMP-011-000001-2
HDR_F_1X3_CMP-002-00285-1 x 3
HDR_F_1_CMP-002-00263-1
691221120002_CMP-002-00600-1 x 3
ESWI-EG1218_V_CMP-011-00006-2
LED-2P-2.28-3MM_CMP-007-00006-3
HDR_F_1X4_CMP-002-00296-1 x 2
HDR_F_1X6_CMP-002-00299-1 x 2
FP-S6B-ZR_LF_SN-MFG_CMP-002-00598-3 x 2
standoff x 4
screws-plastic x 4
