ManiTiTz/raunkerfi/rover-build/SWCAD/SWCAD/ASM-Rover-Layer1.SLDASM

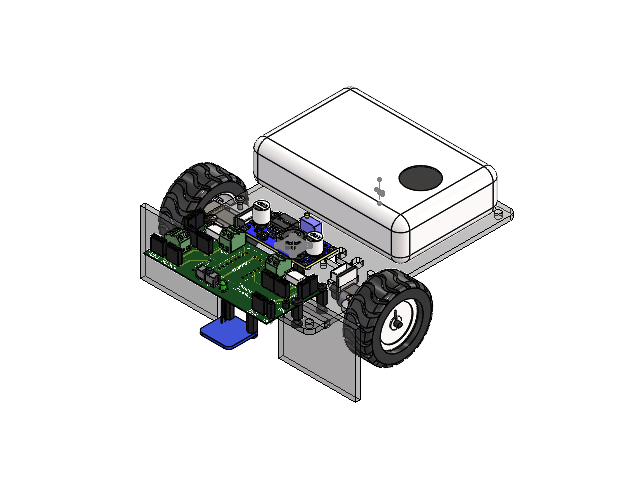
[picture p54: CAD file, 2026-10-19]
rover-build/SWCAD/SWCAD/ASM-Rover-Layer1.SLDASM
baseplate-marcel
motor x 2
bracket-motor x 2
nuts-metal x 6
hub x 2
tire x 2
screws-metal x 6
caster-dfrobot225
spacer-caster x 2
washers-metal x 2
Board^ADIY-LM2596
RES_3296W^ADIY-LM2596
TO-263-5^ADIY-LM2596
CAP_SMD_AL_08.0x10.0^ADIY-LM2596 x 2
RES_SMD_0603^ADIY-LM2596 x 2
CAP_SMD_0603_H0.50^ADIY-LM2596 x 2
001^CDRH125_ADIY-LM2596
002^CDRH125_ADIY-LM2596
005^CDRH125_ADIY-LM2596 x 2
003^CDRH125_ADIY-LM2596
Diode_DO214AC(SMA)^ADIY-LM2596
LED_0603_Green^ADIY-LM2596
standoff x 8
screws-plastic x 16
sensor-color-tcs34725
RoverMotorPower_BOARD
TP_BLACK_CMP-011-000001-2
HDR_F_1X3_CMP-002-00285-1 x 3
HDR_F_1_CMP-002-00263-1
691221120002_CMP-002-00600-1 x 3
ESWI-EG1218_V_CMP-011-00006-2
LED-2P-2.28-3MM_CMP-007-00006-3
HDR_F_1X4_CMP-002-00296-1 x 2
HDR_F_1X6_CMP-002-00299-1 x 2
FP-S6B-ZR_LF_SN-MFG_CMP-002-00598-3 x 2
bracket-lift x 2
C1020-DC-powerbank
