ManiTiTz/raunkerfi/rover-build/SWCAD/SWCAD/ASM-Rover.SLDASM

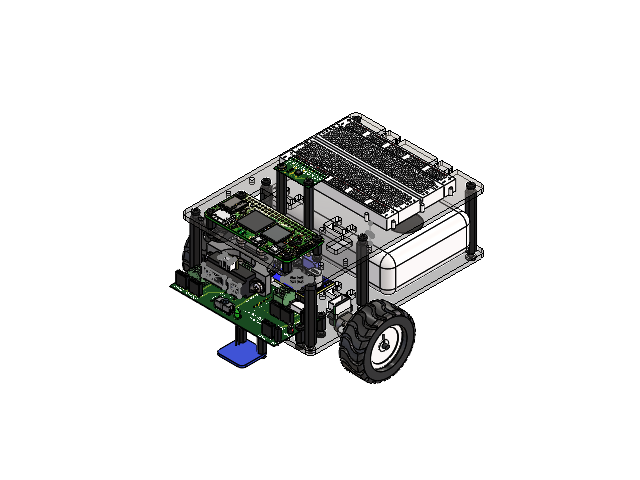
[picture p55: CAD file, 2026-10-19]
rover-build/SWCAD/SWCAD/ASM-Rover.SLDASM
baseplate-marcel x 2
motor x 2
bracket-motor x 2
nuts-metal x 10
hub x 2
tire x 2
screws-metal x 10
caster-dfrobot225
spacer-caster x 2
washers-metal x 2
Board^ADIY-LM2596
RES_3296W^ADIY-LM2596
TO-263-5^ADIY-LM2596
CAP_SMD_AL_08.0x10.0^ADIY-LM2596 x 2
RES_SMD_0603^ADIY-LM2596 x 2
CAP_SMD_0603_H0.50^ADIY-LM2596 x 2
001^CDRH125_ADIY-LM2596
002^CDRH125_ADIY-LM2596
005^CDRH125_ADIY-LM2596 x 2
003^CDRH125_ADIY-LM2596
Diode_DO214AC(SMA)^ADIY-LM2596
LED_0603_Green^ADIY-LM2596
standoff x 20
screws-plastic x 40
sensor-color-tcs34725
RoverMotorPower_BOARD
TP_BLACK_CMP-011-000001-2
HDR_F_1X3_CMP-002-00285-1 x 3
HDR_F_1_CMP-002-00263-1
691221120002_CMP-002-00600-1 x 3
ESWI-EG1218_V_CMP-011-00006-2
LED-2P-2.28-3MM_CMP-007-00006-3
HDR_F_1X4_CMP-002-00296-1 x 2
HDR_F_1X6_CMP-002-00299-1 x 2
FP-S6B-ZR_LF_SN-MFG_CMP-002-00598-3 x 2
C1020-DC-powerbank
AliExpress-ICM20948-IMU_BOARD
RESC0402(1005)_L_CMP-009-00066-2
RESC0402(1005)_L_CMP-009-00071-2
QFN40P300X300X105-25N_CMP-010-00031-4
CAPC1005X56X25LL10T15_CMP-001-00001-6 x 3
PCB, Raspberry Pi Zero 2 W
RP3A0-AU 2105 201221C, Raspberry Pi Zero 2 W
MicroUSB Port, Raspberry Pi Zero 2 W x 2
SD Card Slot, Raspberry Pi Zero 2 W
Wireless Module Cover, Raspberry Pi Zero 2 W
Crystal Resonator, Raspberry Pi Zero 2 W
LED, Raspberry Pi Zero 2 W
Diode, Schottky, Raspberry Pi Zero 2 W
54548-2271, 22 Pin FPC Connector, Raspberry Pi Zero 2 W
Mini HDMI Receptacle Port, Raspberry Pi Zero 2 W
PAM2306AYPKE, Switching Voltage Regulators Dual PWM Step-Down 40uA 1A 1.5MHz, Raspberry Pi Zero 2 W
RT9081A-1BGQZA, Fixed LDO Voltage Regulator, 0.8V-5.5Vin, 140mV drop, 1.25Vout, 0.5Aout, Raspberry Pi Zero 2 W
RT8088AWSC, IC Reg Buck Prog 3A Sync 15WLCSP, Raspberry Pi Zero 2 W
SMD Inductor, Configurable, Raspberry Pi Zero 2 W x 2
SMD Capacitor, Configurable, Raspberry Pi Zero 2 W x 56
SMD Resistor, Configurable, Raspberry Pi Zero 2 W x 21
bracket-sharp
sensor-Sharp2Y0A21
Main Half-Size Board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
