ManiTiTz/raunkerfi/(list of files, cad)

Other CAD files:
rover-build/SWCAD/SWCAD/Import/LM2596/LM2596.obj
rover-build/SWCAD/SWCAD/Import/LM2596/LM2596_DC-DC_convertor_HW-411.FCStd
rover-build/SWCAD/SWCAD/Import/thingiverse-mount-SharpIR-GP2Y0A21YK0F/files/test.SLDPRT
rover-build/SWCAD/SWCAD/LM2596-DCDC.SLDPRT
rover-build/SWCAD/SWCAD/ASM-Rover.SLDDRW
rover-build/SWCAD/SWCAD/ICM20948-breakout.SLDPRT
rover-build/SWCAD/SWCAD/Import/LM2596/LM2596_DC-DC_convertor_HW-411.iges
rover-build/SWCAD/SWCAD/Import/grabcad-dc-dc-lm2596/ADIY-LM2596.SLDASM
rover-build/SWCAD/SWCAD/Import/grabcad-dc-dc-lm2596/interface-board.SLDPRT
rover-build/SWCAD/SWCAD/Import/grabcad-half-size-breadboard/Half-Size Breadboard.SLDASM
rover-build/SWCAD/SWCAD/Import/grabcad-half-size-breadboard/Half-Size Side Rail.SLDPRT
rover-build/SWCAD/SWCAD/Import/grabcad-half-size-breadboard/Main Half-Size Board.SLDPRT
rover-build/SWCAD/SWCAD/Import/grabcad-mount-sharpir/BracketForir.SLDPRT
rover-build/SWCAD/SWCAD/Import/grabcad-raspi-zero-w-2/54548-2271, 22 Pin FPC Connector, Raspberry Pi Zero 2 W.SLDPRT
rover-build/SWCAD/SWCAD/Import/grabcad-raspi-zero-w-2/Crystal Resonator, Raspberry Pi Zero 2 W.SLDPRT
rover-build/SWCAD/SWCAD/Import/grabcad-raspi-zero-w-2/Diode, Schottky, Raspberry Pi Zero 2 W.SLDPRT
rover-build/SWCAD/SWCAD/Import/grabcad-raspi-zero-w-2/LED, Raspberry Pi Zero 2 W.SLDPRT
rover-build/SWCAD/SWCAD/Import/grabcad-raspi-zero-w-2/MicroUSB Port, Raspberry Pi Zero 2 W.SLDPRT
rover-build/SWCAD/SWCAD/Import/grabcad-raspi-zero-w-2/Mini HDMI Receptacle Port, Raspberry Pi Zero 2 W.SLDPRT
rover-build/SWCAD/SWCAD/Import/grabcad-raspi-zero-w-2/PAM2306AYPKE, Switching Voltage Regulators Dual PWM Step-Down 40uA 1A 1.5MHz, Raspberry Pi Zero 2 W.SLDPRT
rover-build/SWCAD/SWCAD/Import/grabcad-raspi-zero-w-2/PCB, Raspberry Pi Zero 2 W.SLDPRT
rover-build/SWCAD/SWCAD/Import/grabcad-raspi-zero-w-2/RP3A0-AU 2105 201221C, Raspberry Pi Zero 2 W.SLDPRT
rover-build/SWCAD/SWCAD/Import/grabcad-raspi-zero-w-2/RT8088AWSC, IC Reg Buck Prog 3A Sync 15WLCSP, Raspberry Pi Zero 2 W.SLDPRT
rover-build/SWCAD/SWCAD/Import/grabcad-raspi-zero-w-2/RT9081A-1BGQZA, Fixed LDO Voltage Regulator, 0.8V-5.5Vin, 140mV drop, 1.25Vout, 0.5Aout, Raspberry Pi Zero 2 W.SLDPRT
rover-build/SWCAD/SWCAD/Import/grabcad-raspi-zero-w-2/Raspberry Pi Zero 2 W.SLDASM
rover-build/SWCAD/SWCAD/Import/grabcad-raspi-zero-w-2/SD Card Slot, Raspberry Pi Zero 2 W.SLDPRT
rover-build/SWCAD/SWCAD/Import/grabcad-raspi-zero-w-2/SMD Capacitor, Configurable, Raspberry Pi Zero 2 W.SLDPRT
rover-build/SWCAD/SWCAD/Import/grabcad-raspi-zero-w-2/SMD Inductor, Configurable, Raspberry Pi Zero 2 W.SLDPRT
rover-build/SWCAD/SWCAD/Import/grabcad-raspi-zero-w-2/SMD Resistor, Configurable, Raspberry Pi Zero 2 W.SLDPRT
rover-build/SWCAD/SWCAD/Import/grabcad-raspi-zero-w-2/Wireless Module Cover, Raspberry Pi Zero 2 W.SLDPRT
rover-build/SWCAD/SWCAD/Import/thingiverse-mount-SharpIR-GP2Y0A21YK0F/files/Support_Capteur_Sharp2.stl
rover-build/SWCAD/SWCAD/baseplate-marcel.SLDDRW
rover-build/SWCAD/SWCAD/bolt_plastic.SLDPRT
rover-build/SWCAD/SWCAD/lockwasher.SLDPRT
rover-build/SWCAD/SWCAD/screws-metal.SLDPRT
rover-build/SWCAD/SWCAD/screws-plastic.SLDPRT
rover-build/SWCAD/SWCAD/washers-metal.SLDPRT
