ManiTiTz/raunkerfi/rover-build/SWCAD/SWCAD/Import/LM2596 DC-DC convertor HW-411 - 5719964/README.txt

LM2596 DC-DC convertor HW-411 by StefaanVC on Thingiverse: https://www.thingiverse.com/thing:5719964

Summary:
Simplified version of a popular LM2596 based breakout board (HW-411) for DC-DC conversion.Can be used to in projects that use this breakout board to check the fitting or compatibility.
