ManiTiTz/raunkerfi/rover-build/MECH-CPSY-Checkoff.pdf

Quantity | Item | Present? | URL
| 1 Raspberry Pi Zero 2 W | | https://thepihut.com/products/raspberry-pi-zero-2?variant=43855634497731
| 1 Micro-SD card (16 GB) | | https://www.aliexpress.com/item/1005002798030401.html
| 1 GP2Y0A02YK IR distance sensor | | https://www.aliexpress.com/item/1005007556918786.html
| 1 TCS34725 color sensor breakout | | https://www.aliexpress.com/item/1005006745936264.html
| 1 ICM-20948 Sensor Module 9 Axis MEMS Motion Tracking Device Sensor | | https://www.aliexpress.com/item/1005005499263696.html
| 1 DRV8833 DC Motor Drive Board Module Dual Motor Driver | | https://www.aliexpress.com/item/1005008401794306.html
| 1 MCP3008-I/P Analogue to Digital converter | | https://www.aliexpress.com/item/1005004654002523.htm
| 1 0.96 inch OLED IIC Display Module SSD 1306 | | https://www.aliexpress.com/item/1005004355547926.html
| 1 Half sized breadboard | | https://www.aliexpress.com/item/1005005995135021.html
| 1 Male/Female Jumper Wires - 20 x 6" (150mm) | | https://www.aliexpress.com/item/1005007306722061.html
| 1 Male/Male Jumper Wires - 20 x 6" (150mm) | | https://www.aliexpress.com/item/1005007306722061.html
| 2 Micro Metal Geared motor w/Encoder - 12V 300RPM 50:1 | | https://www.aliexpress.com/item/1005006213216702.html
| 1 Wheel 42x19mm (Pair) | | https://www.aliexpress.com/item/32809043739.html
| 1 Steel Swivel Ball Caster Wheel | | https://www.aliexpress.com/item/1005003191891234.html
| 1 Micro Metal Gearmotor Extended Bracket (Pair) | | https://www.aliexpress.com/item/1005006048876448.html
| 1 Powerbank (5Ah, PD, 2 USB outputs) | | https://www.aliexpress.com/item/1005008649308284.html
| 1 DC 3.5mm x 1.35mm Male Plug DC Power Wire Pigtail | | https://www.aliexpress.com/item/1005007441809776.html
| 1 LM2596S DC High Efficiency Voltage Regulator | | https://www.aliexpress.com/item/1005008604867476.html
| 1 30cm USB-A Micro USB cable | | https://www.aliexpress.com/item/1005008421975788.html
| 1 Acrylic Baseplates | | MECH/CPSY V2025-6 100x135mm
| 6 M2.5 6mm Vinyl Standoff screws set | | https://www.aliexpress.com/item/1005007856069149.html
| 2 M2.5 15mm Vinyl Standoff screws set | | https://www.aliexpress.com/item/1005007856069149.html
| 6 M3 30mm Vinyl Standoff screws set | | https://www.aliexpress.com/item/1005007856069149.html
| 2 Rubberbands 4cm | | https://www.aliexpress.com/item/1005007404087634.html
| 1 IR sensor bracket | | https://www.thingiverse.com/thing:2987475
| 4 M3 screw, nut, washer, lock washer.
| 1 LED 3.5mm
| 2 330 Ohm resistor
| 2 680 Ohm resistor
| 1 1 KOhm resistor
| 1 220 Ohm resistor
| 1 3Pin Female Header 2.54mm | | https://www.aliexpress.com/item/1005003610333849.html
| 1 12Pin Female Header 2.54mm | | https://www.aliexpress.com/item/1005003610333849.html
| 1 PCB Board Prototype Board Blue 2x8cm | | https://www.aliexpress.com/item/1005007129593182.html
| 1 Micro USB OTG Adapter Micro USB Male To USB 2.0 Female Cable | | https://www.aliexpress.com/item/1005004409010013.html
| 1 Mini -compatible to HDMI-compatible Adapter | | https://www.aliexpress.com/item/1005006266908369.html
