ManiTiTz/raunkerfi/rover-build/SWCAD/SWCAD/ASM-Rover-drawings.pdf

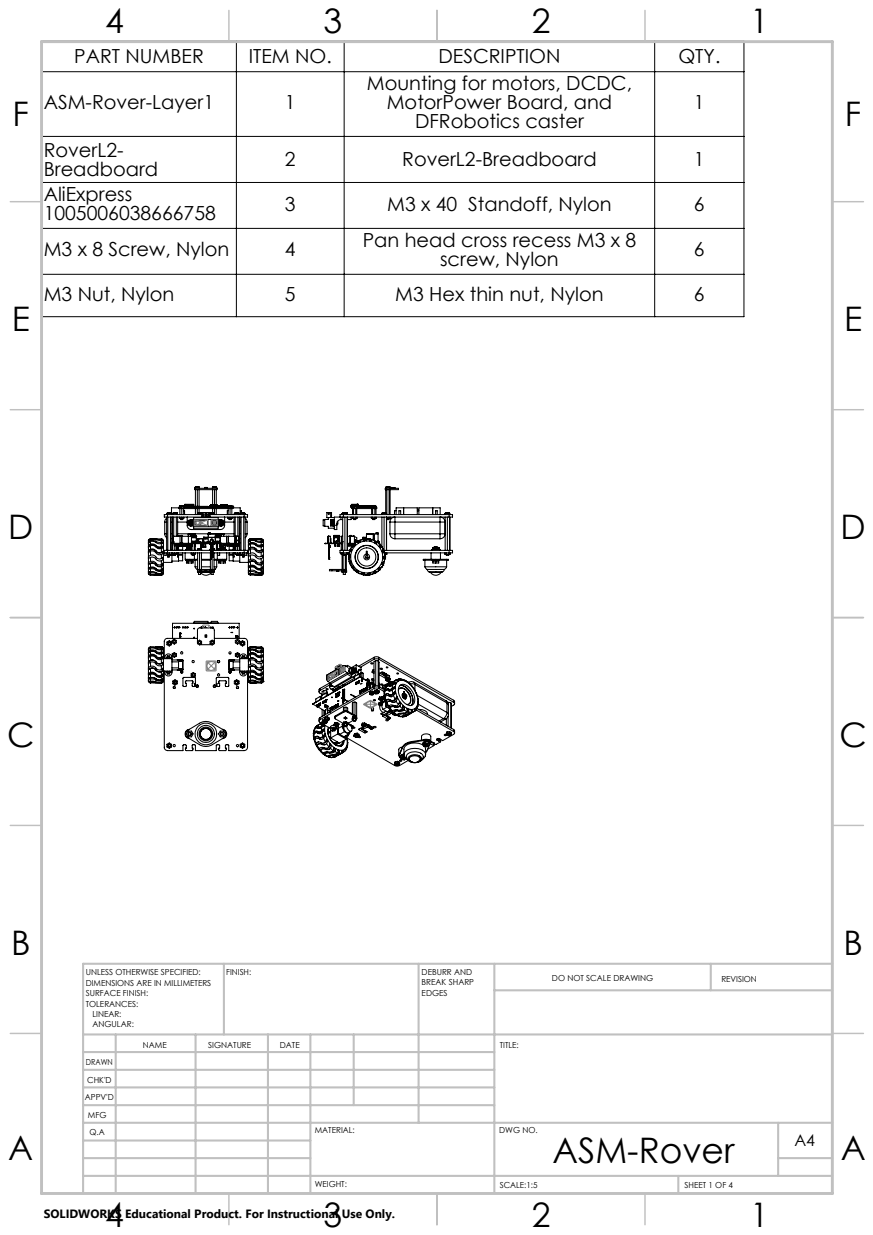
[picture p56: page 1]
FINISH:; DEBURR AND; BREAK SHARP; DO NOT SCALE DRAWING; REVISION; SCALE:1:5; SHEET 1 OF 4

PART NUMBER | ITEM NO. | DESCRIPTION | QTY.
ASM-Rover-Layer1 | 1 | Mounting for motors, DCDC, MotorPower Board, and DFRobotics caster | 1

RoverL2-Breadboard | 2 | RoverL2-Breadboard | 1
AliExpress 1005006038666758 | 3 | M3 x 40 Standoff, Nylon | 6
M3 x 8 Screw, Nylon | 4 | Pan head cross recess M3 x 8 screw, Nylon | 6

M3 Nut, Nylon | 5 | M3 Hex thin nut, Nylon | 6

UNLESS OTHERWISE SPECIFIED:
DIMENSIONS ARE IN MILLIMETERS
SURFACE FINISH:
TOLERANCES:
LINEAR:
ANGULAR:

NAME | SIGNATURE | DATE | | | | TITLE:

DRAWN
CHK'D
APPV'D
MFG
Q.A | | | | MATERIAL: | DWG NO. ASM-Rover | A4

SOLIDWORKS Educational Product. For Instructional Use Only.

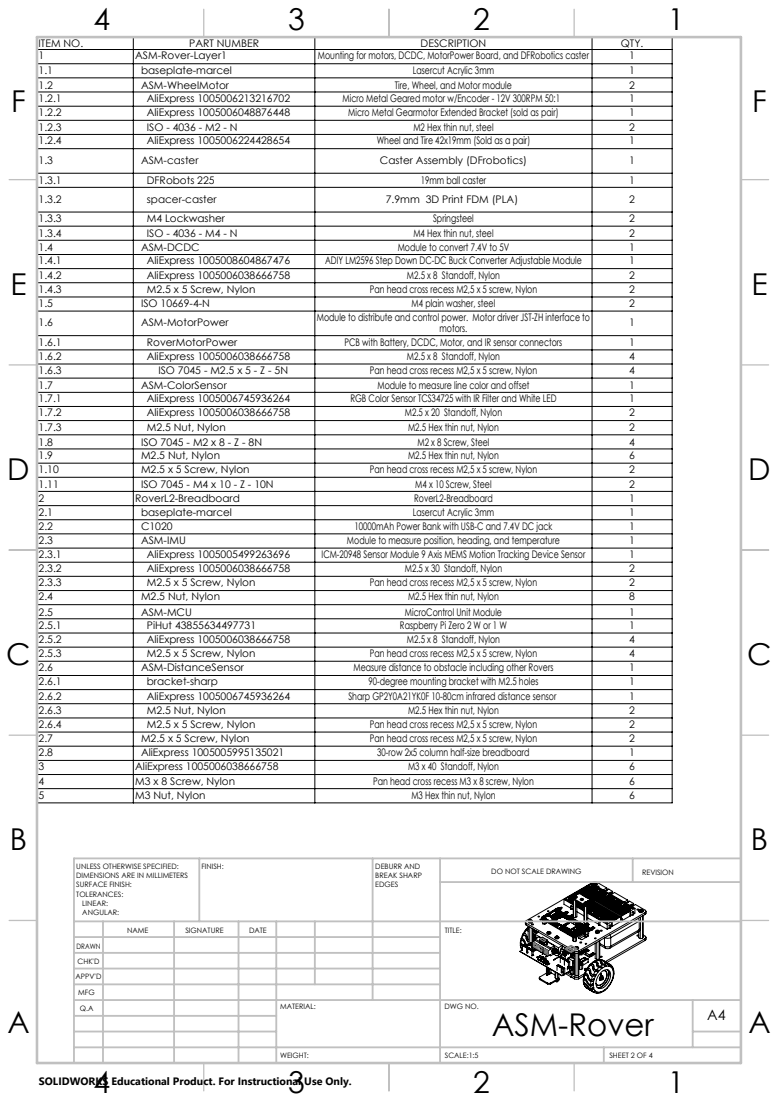
[picture p57: page 2]
ITEM NO.; PART NUMBER; DESCRIPTION; QTY.; ASM-Rover-Layer1; Mounting for motors, DCDC, MotorPower Board, and DFRobotics caster; baseplate-marcel; Lasercut Acrylic 3mm; ASM-WheelMotor; Tire, Wheel, and Motor module; AliExpress 1005006213216702; Micro Metal Geared motor w/Encoder - 12V 300RPM 50:1; AliExpress 1005006048876448; Micro Metal Gearmotor Extended Bracket (sold as pair); ISO - 4036 - M2 - N; M2 Hex thin nut, steel; AliExpress 1005006224428654; Wheel and Tire 42x19mm (Sold as a pair)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

UNLESS OTHERWISE SPECIFIED:
DIMENSIONS ARE IN MILLIMETERS
SURFACE FINISH:
TOLERANCES:
LINEAR:
ANGULAR:

NAME | SIGNATURE | DATE | TITLE:

DRAWN
CHK'D
APPV'D
MFG

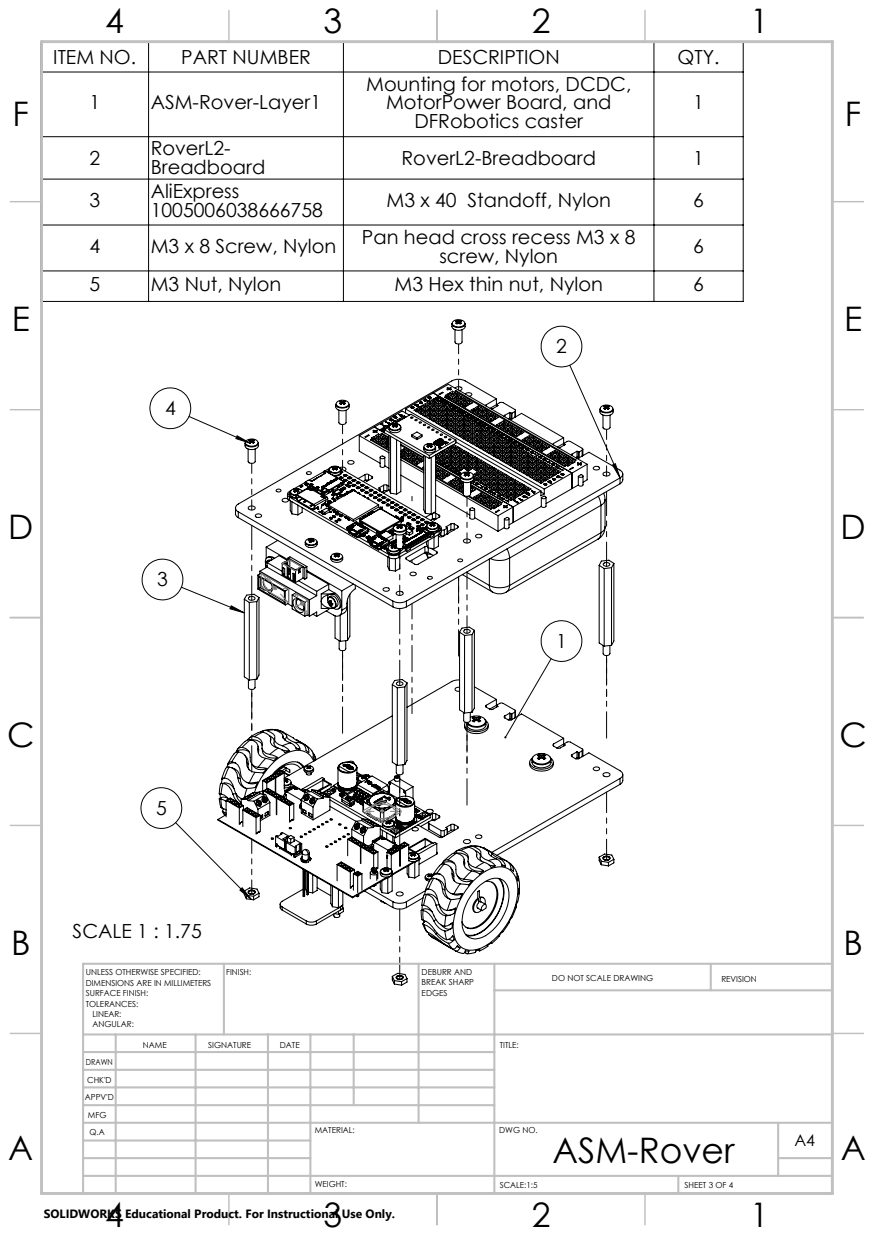
[picture p58: page 3]
SCALE 1 : 1.75; FINISH:; DEBURR AND; BREAK SHARP; DO NOT SCALE DRAWING; REVISION

ITEM NO. | PART NUMBER | DESCRIPTION | QTY.
1 | ASM-Rover-Layer1 | Mounting for motors, DCDC, MotorPower Board, and DFRobotics caster | 1

2 | RoverL2-Breadboard | RoverL2-Breadboard | 1
3 | AliExpress 1005006038666758 | M3 x 40 Standoff, Nylon | 6
4 | M3 x 8 Screw, Nylon | Pan head cross recess M3 x 8 screw, Nylon | 6
5 | M3 Nut, Nylon | M3 Hex thin nut, Nylon | 6

UNLESS OTHERWISE SPECIFIED:
DIMENSIONS ARE IN MILLIMETERS
SURFACE FINISH:
TOLERANCES:
LINEAR:
ANGULAR:

NAME | SIGNATURE | DATE | TITLE:

DRAWN
CHK'D
APPV'D
MFG

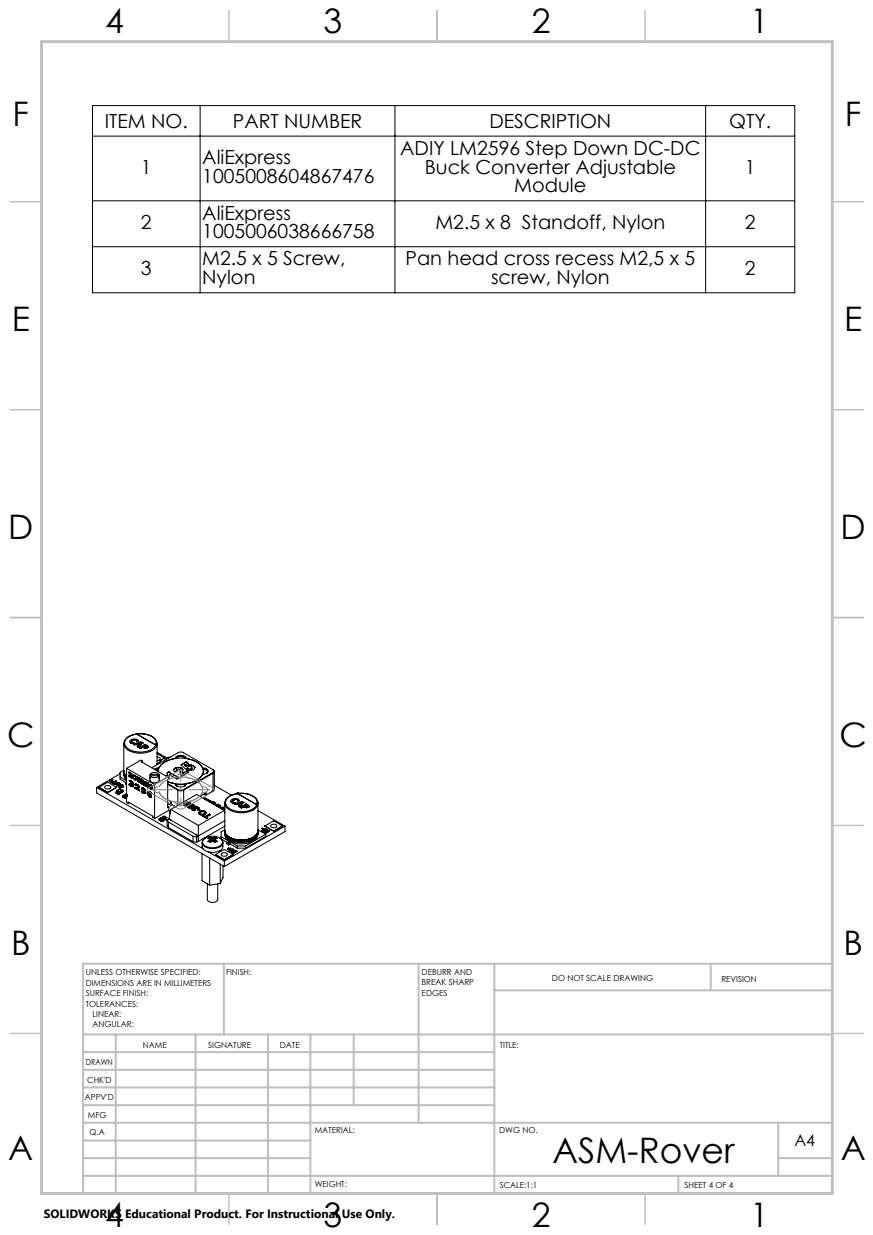
[picture p59: page 4]
FINISH:; DEBURR AND; BREAK SHARP; DO NOT SCALE DRAWING; REVISION; SCALE:1:1; SHEET 4 OF 4

ITEM NO. | PART NUMBER | DESCRIPTION | QTY.
1 | AliExpress 1005008604867476 | ADIY LM2596 Step Down DC-DC Buck Converter Adjustable Module | 1

2 | AliExpress 1005006038666758 | M2.5 x 8 Standoff, Nylon | 2
3 | M2.5 x 5 Screw, Nylon | Pan head cross recess M2,5 x 5 screw, Nylon | 2

UNLESS OTHERWISE SPECIFIED:
DIMENSIONS ARE IN MILLIMETERS
SURFACE FINISH:
TOLERANCES:
LINEAR:
ANGULAR:

NAME | SIGNATURE | DATE | TITLE:

DRAWN
CHK'D
APPV'D
MFG
