ManiTiTz/raunkerfi/rover-build/SWCAD/SWCAD/ICM20948-render.pdf

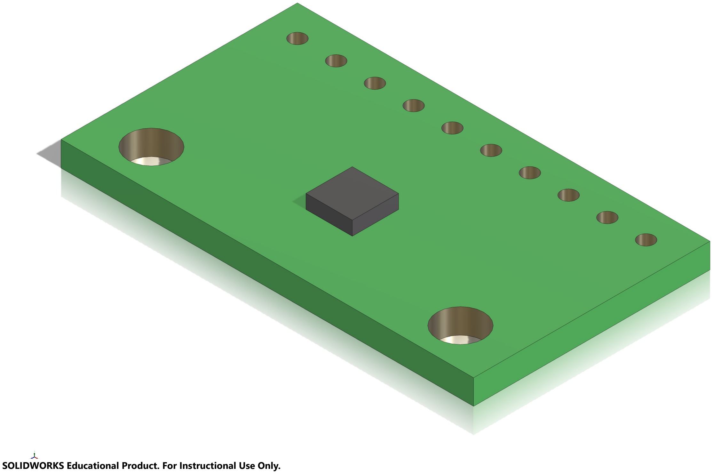
[picture p60: page 1]

SOLIDWORKS Educational Product. For Instructional Use Only.
