ManiTiTz/raunkerfi/rover-build/1-caster-lower-deck.jpeg

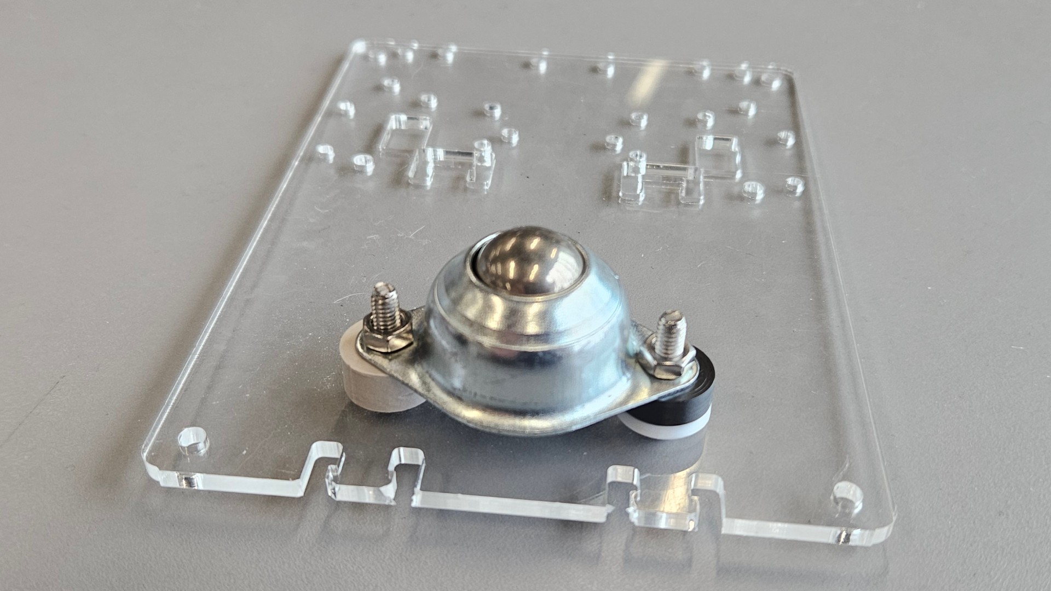
rover-build/1-caster-lower-deck.jpeg
