ManiTiTz/raunkerfi/rover-build/2-resistive-load.jpeg

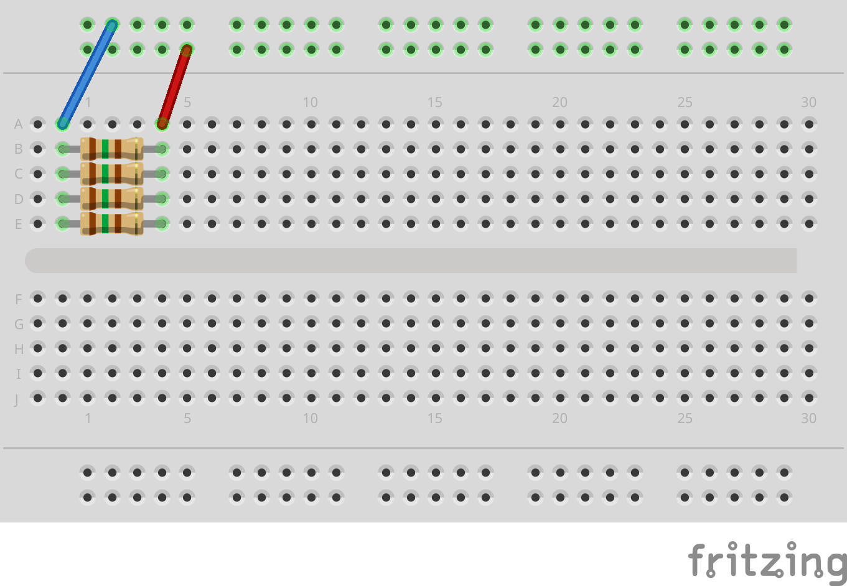
rover-build/2-resistive-load.jpeg
