ManiTiTz/raunkerfi/rover-build/3-upper-deck-top.jpeg

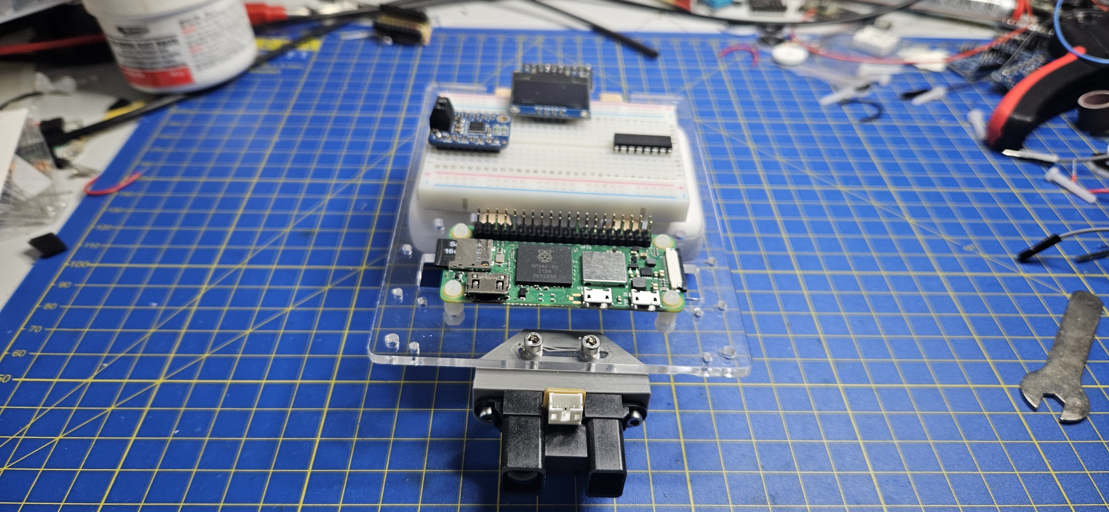
rover-build/3-upper-deck-top.jpeg
