ManiTiTz/raunkerfi/rover-build/4-upper-deck-b.jpeg

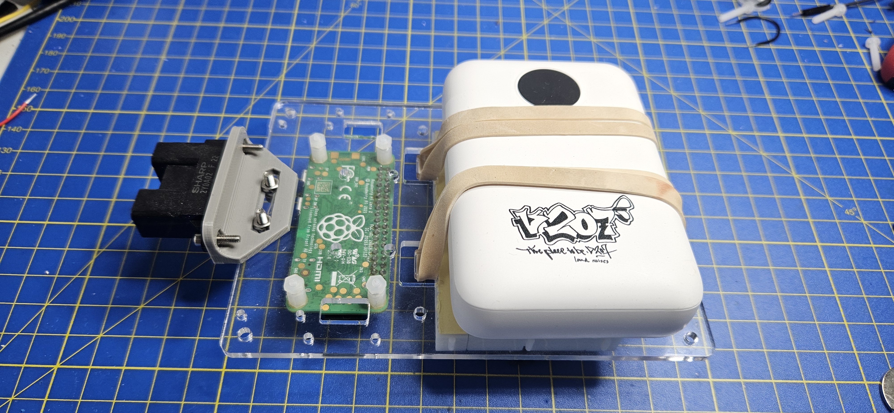
rover-build/4-upper-deck-b.jpeg
