ManiTiTz/raunkerfi/rover-build/5-imu-on-standoffs.jpeg

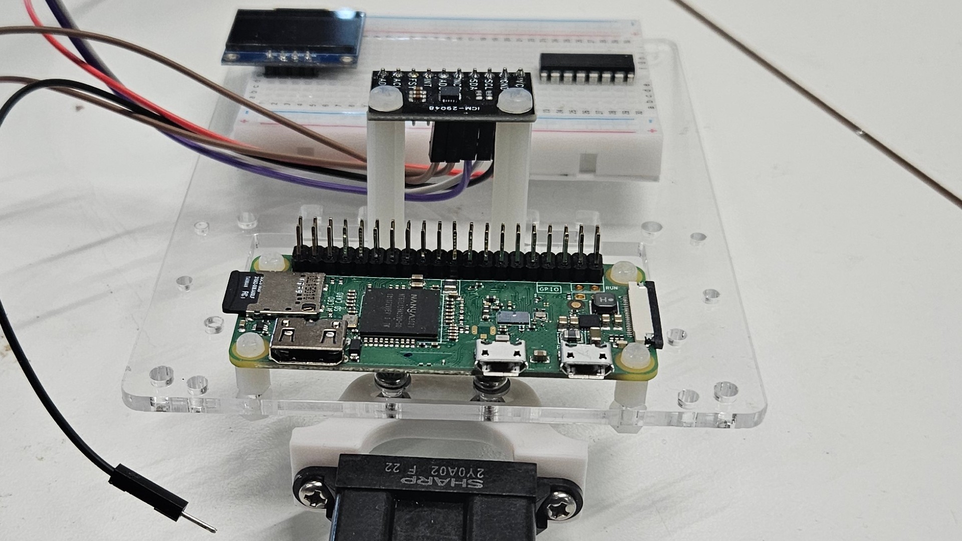
rover-build/5-imu-on-standoffs.jpeg
