ManiTiTz/raunkerfi/rover-build/6-pdboard.png

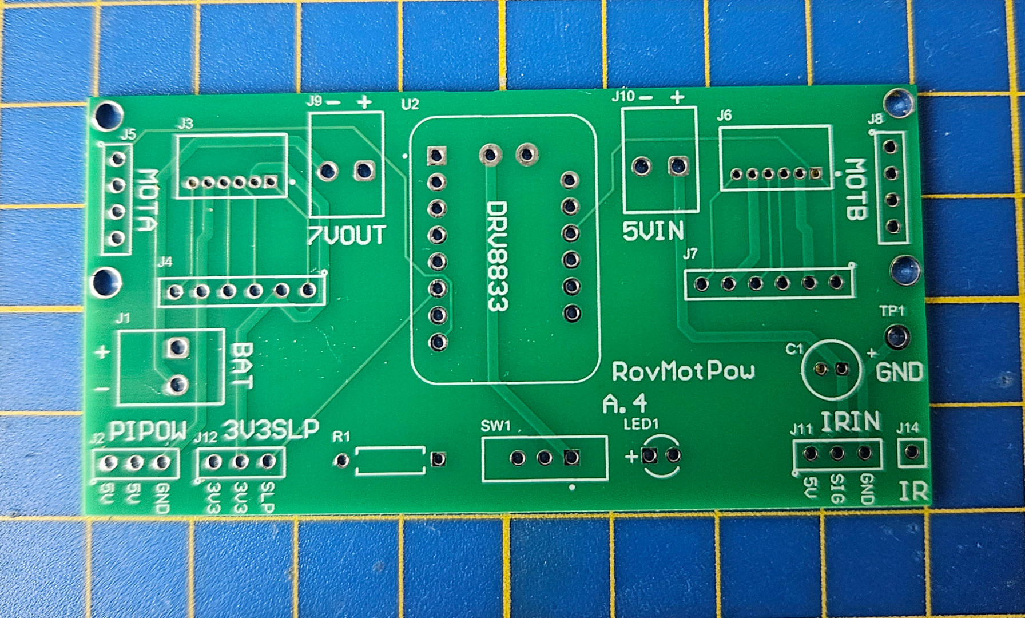
rover-build/6-pdboard.png
