ManiTiTz/raunkerfi/rover-build/7-pdboard-soldered.jpeg

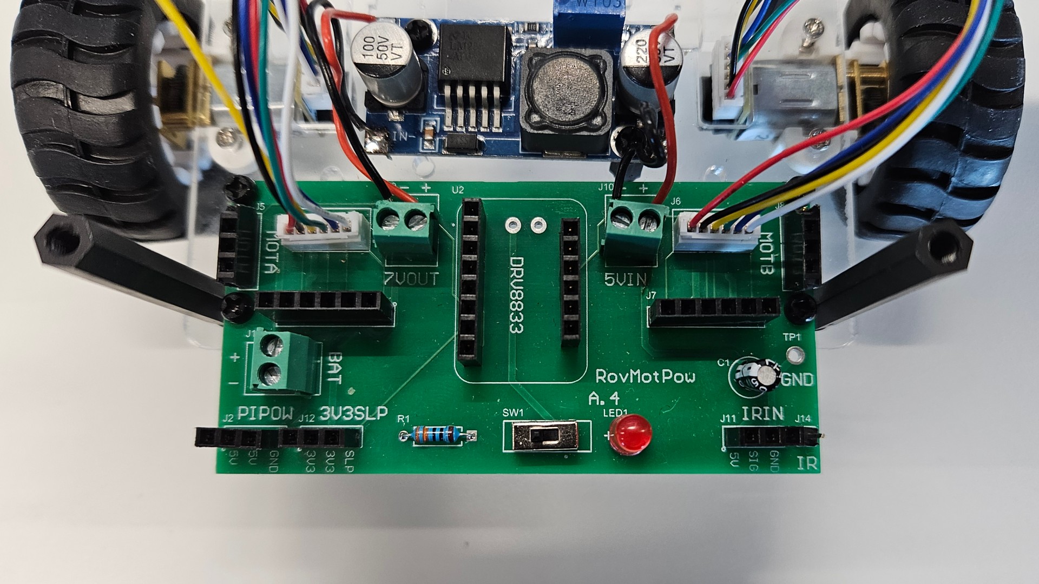
rover-build/7-pdboard-soldered.jpeg
