ManiTiTz/raunkerfi/rover-build/8-husb238.png

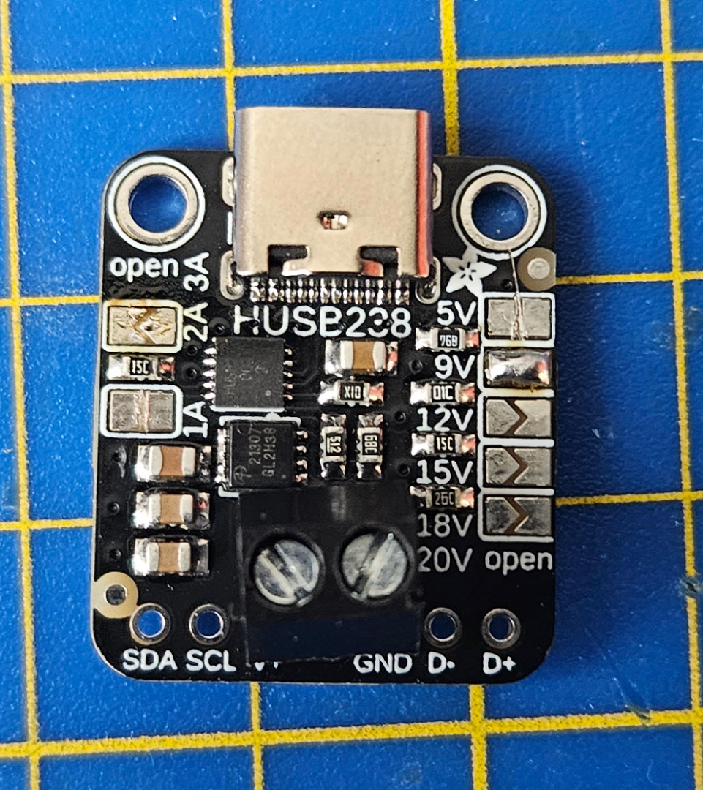
rover-build/8-husb238.png
