ManiTiTz/raunkerfi/rover-build/9-converter.png

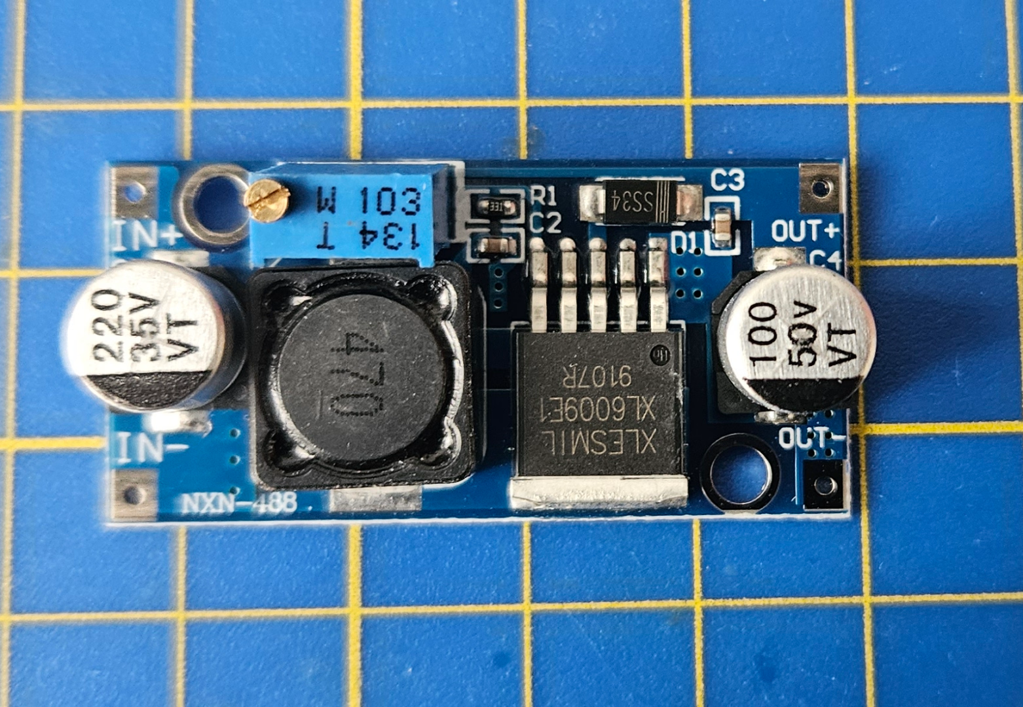
rover-build/9-converter.png
