ManiTiTz/raunkerfi/rover-build/10-power-wired.jpeg

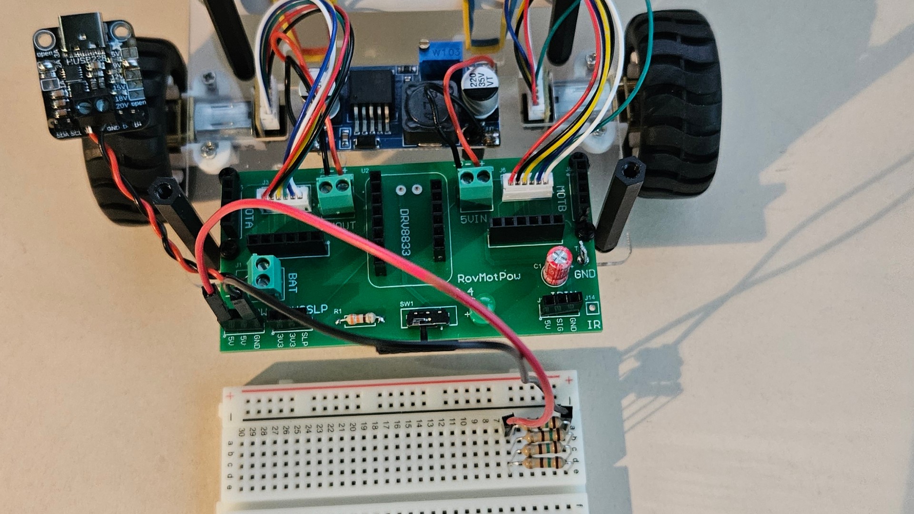
rover-build/10-power-wired.jpeg
