ManiTiTz/raunkerfi/rover-build/SWCAD/SWCAD/ASM-Rover.PNG

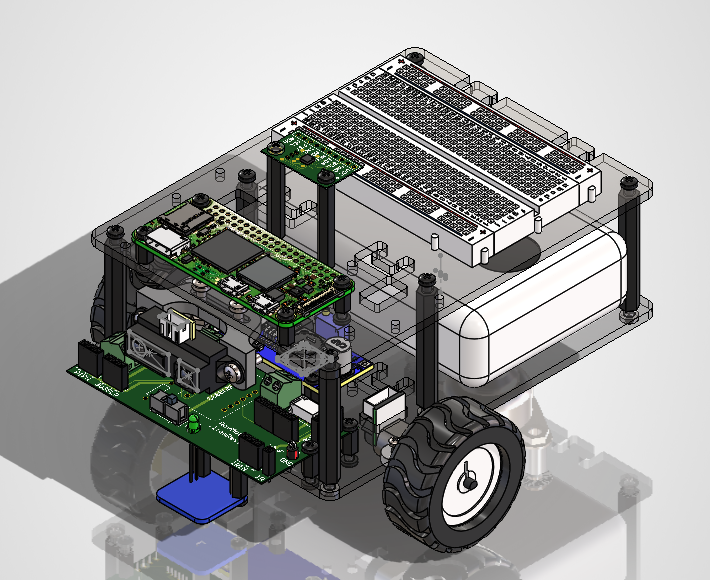
rover-build/SWCAD/SWCAD/ASM-Rover.PNG
