ManiTiTz/raunkerfi/rover-build/SWCAD/SWCAD/Import/grabcad-sharp-2Y0A21/SharpIR.JPG

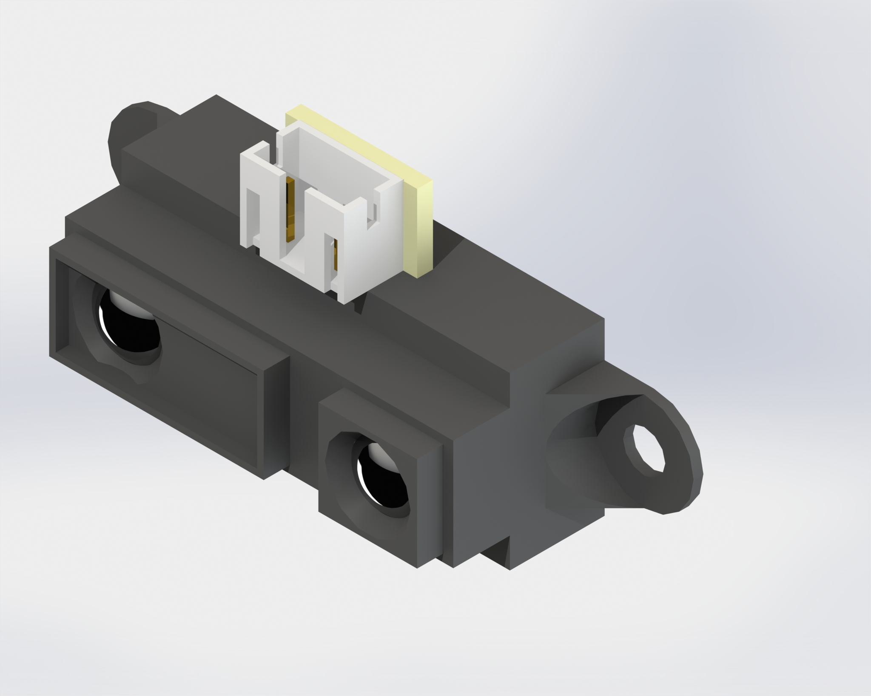
rover-build/SWCAD/SWCAD/Import/grabcad-sharp-2Y0A21/SharpIR.JPG
