ManiTiTz/raunkerfi/rover-build/SWCAD/SWCAD/Import/LM2596 DC-DC convertor HW-411 - 5719964/images/f8d0b8f5-7295-4665-9b2b-4a1fd251f012.png

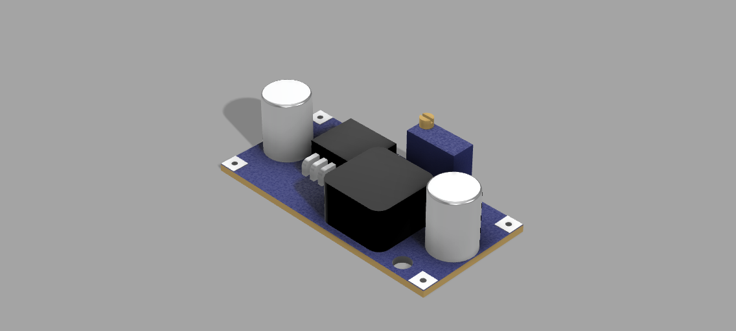
rover-build/SWCAD/SWCAD/Import/LM2596 DC-DC convertor HW-411 - 5719964/images/f8d0b8f5-7295-4665-9b2b-4a1fd251f012.png
