ManiTiTz/raunkerfi/rover-build/schematic.pdf

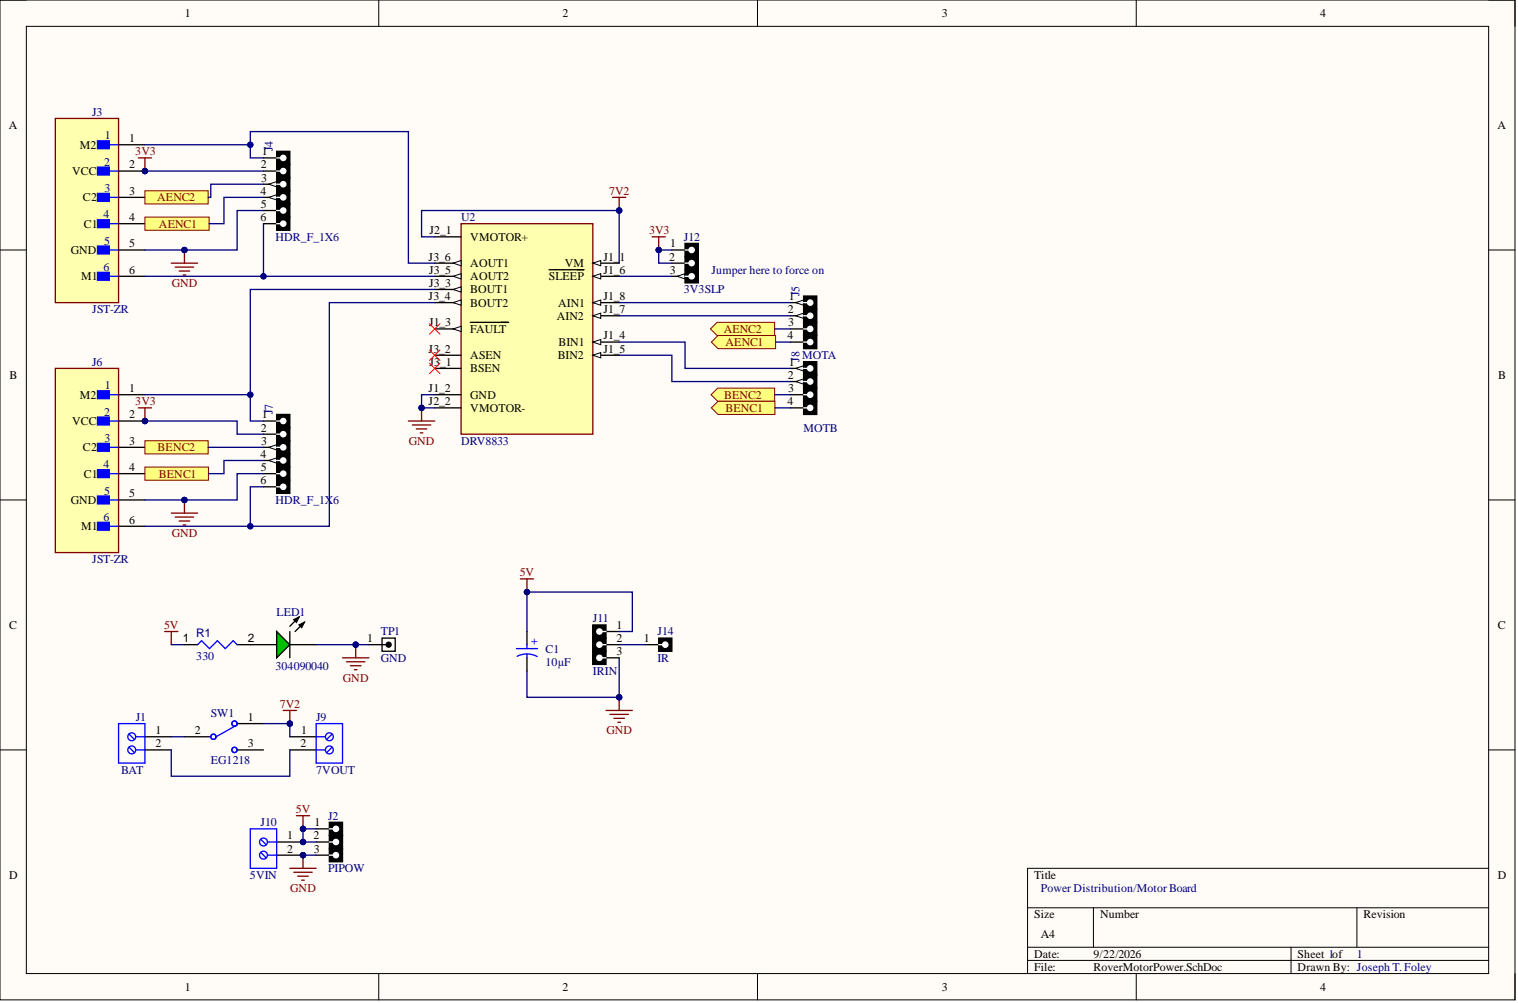
[picture p74: page 1]

Jumper here to force on

BENC1

Title
Power Distribution/Motor Board
