ManiTiTz/raunkerfi/rover-build/SWCAD/SWCAD/baseplate-marcel.pdf

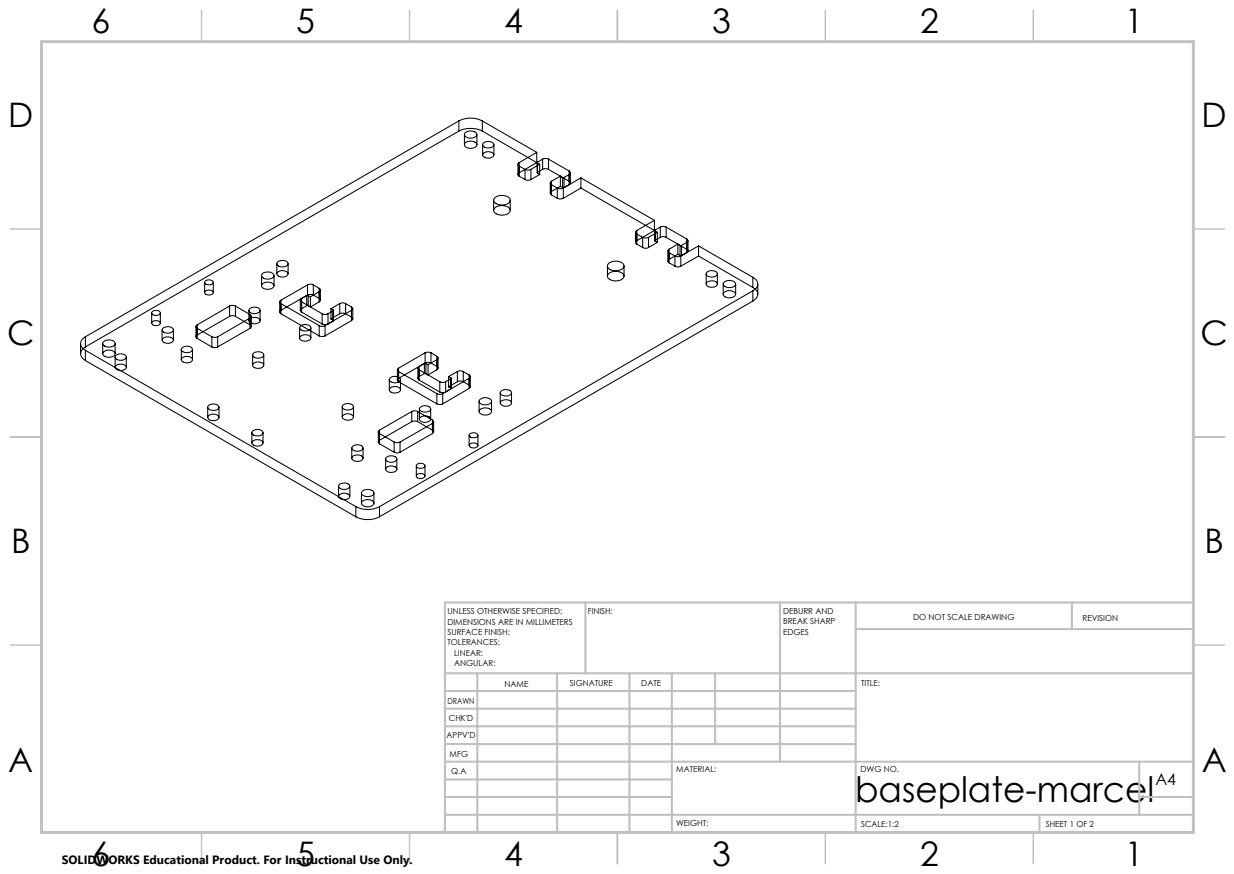
[picture p75: page 1]
FINISH:; DEBURR AND; BREAK SHARP; DO NOT SCALE DRAWING; REVISION; SCALE:1:2; SHEET 1 OF 2

UNLESS OTHERWISE SPECIFIED:
DIMENSIONS ARE IN MILLIMETERS
SURFACE FINISH:
TOLERANCES:
LINEAR:
ANGULAR:

NAME | SIGNATURE | DATE | | | | TITLE:

DRAWN
CHK'D
APPV'D
MFG
Q.A | | | | MATERIAL: | DWG NO. baseplate-marcel | A4

SOLIDWORKS Educational Product. For Instructional Use Only.

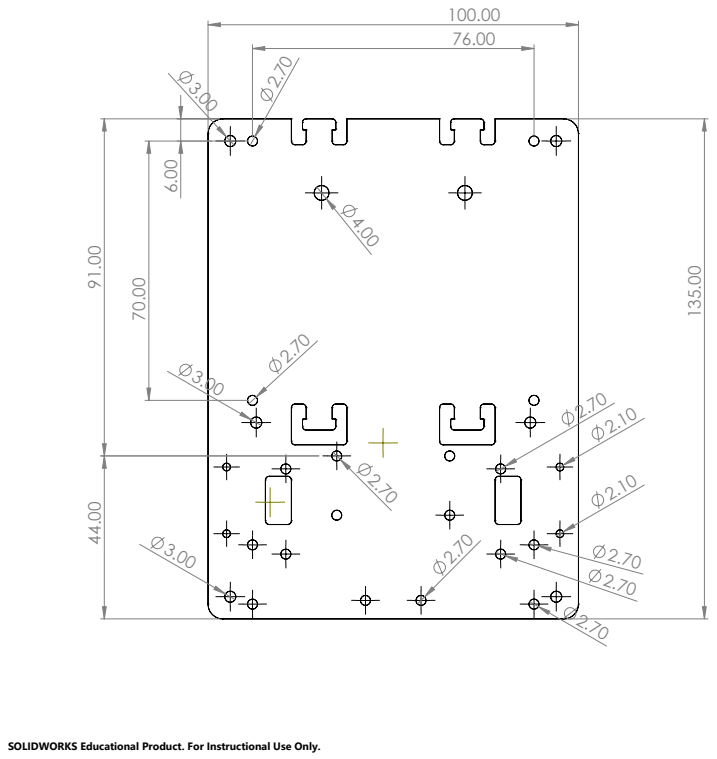
[picture p76: page 2]

SOLIDWORKS Educational Product. For Instructional Use Only.
