ManiTiTz/raunkerfi/(list of files, drawings)

Other design files:
6lab/rover-color-sensor.fzz
6lab/verify-v5.fzz
9Lab/lab9-distance-sensor.fzz
Lab2/gyro.fzz
Lab2/lab2.fzz
Lab2/Untitled Sketch 3.fzz
Lab2/Untitled Sketch 4.fzz
Lab2/Untitled Sketch 5.fzz
Lab5/motor-wiring.fzz
